Tannyr-Singleterry/ECE590_SeniorDesign/Documents/Draft A/ECE590__October_DesignSolution_Report.docx

Wildcat Rocketry Universal Flight Computer

LOGO GOES HERE

Submitted By:

The Apogeeniuses

Tannyr Singleterry

Gannon Bird

Ethan Benne

Nathan Emerson

10 October 2024

Executive Summary

Temp

Table of Contents

Executive Summary……………………………………………………………………………………………………………………..2

Table of Contents…………………………………………………………………………………………………………………………3

Project Description……………………………………………………………………………………………………………………...4

Background and Motivation ..X

Problem Statement ..X

Project Requirements ..X

Validation and Acceptance Tests ..X

Verification and Validation Matrix ..X

Data Needed to Support Analysis ..X

Technical Design ..X

Pre-Conceptual and Conceptual Design/Solution Descriptions ..X

Preliminary Design/Solution Description ..X

Detailed Design/Solution Descriptions ..X

Validation and Acceptance Test Results ..X

Assessment of Test Results ..X

Work Plan ..X

Work Breakdown Structure (WBS) & RACI Chart ..X

Schedule Gantt Chart ..X

Prototyping and Testing Protocol ..X

Financial Plan ..X

Proposed Budget ..X

Comparison of Final Expenditures to Budget ..X

Feasibility Assessment ..X

Lessons Learned ..X

Conclusions ..X

References ..X

Appendices ..X

Discussion

Project Description

This project is a Wildcat Rocketry flight computer. The goal of this project is to design and make a flight computer that will take in data from multiple sensors and produce accurate, reliable, and readable flight data.

Background and Motivation

Wildcat rocketry in the past has tried doing a various number of electronics projects. Some of these projects being a flight computer. However, most of these flight computers never got past the designing phase. If they did get past the design phase, they never got more than one board revision. This year Wildcat Rocketry is moving away from trying to design a flight computer and going towards Long Range tracking problem solving. The motivation for this senior design project is to design and construct a flight computer Wildcat Rocketry can be used as another way to get accurate flight data. As well Wildcat Rocketry can have a flight computer that they can build upon later for various other needs.

Project Requirements

Below is a table listing out different requirements for this project. The first ID dealing with power. ID 1.0 talking about the requirement that the flight computer needs to be powered from a 2S LiPo battery. The reason for this is because that is the all the commercial flight computers that Rocketry already uses are powered from these batteries. ID 1.a deals with the fact that Wildcat Rocketry would like the minimum battery life to be 2 hours. With the ideal battery life being 3-4 hours. ID 2 has to deal with the weight of the overall flight computer. Weight matters a significant amount when it comes to a rocket flying, so the less we can have the computer weigh the better. ID 3.0 deals with size. The flight computer must be constrained to a certain size. All the electronics for a rocket go inside of an avionics bay. Which has a certain inner diameter that the flight computer must fit inside of. This inner diameter typically being 3in-5in in width. ID 4.0 deals with cost. The cheaper Wildcat Rocketry and produce these flight computers the better. So we can have money that can go to other projects. ID 5.0 deals with all the Data the flight computer with obtain. Wildcat Rocketry wants the flight computers to store at least three flights worth of flight data. We got this number due to the commercial flight computers on the market hold this amount. ID 5.a talks about being able to take the data from the sensors on the flight computer and turning them into readable flight data. ID 5.b talks about being able to export the data over serial using USB-C and even visualize over WiFi.

ID | Requirement | Description
1.0 | Input Voltage and Current | 2S LiPo
1.a | Minimize Power Use | Design Goal: The longer we can power the board the better. Minimum of 2 hours of battery life. Would like 3-4 hours
2.0 | Weight | Maximum 100 grams
3.0 | Size | Maximum 3 in width, 4 in length
4.0 | Cost | $200 or less
5.0 | Data Logging | Store at least three flights worth of data
5.a | Data Processing | Be able to process data from sensors into readable flight data
5.b | Data Export | Be able to export that data over serial or visualize over WiFi

Validation and Acceptance Tests

We will be able to verify and validate our final design by demonstrating all the project requirements. We can demonstrate the power usage by putting the flight computer under load for a set amount of time and seeing how much voltage is left in the battery after. We can demonstrate the weight and size by measuring using the appropriate devices. The plan is to have two different board revisions, the first one being a testing unit with buttons and switches for debugging. While the second revision would be one that flies and gathers data actively during the flight. We can demonstrate the data processing, storage, and exporting using the first revision testing board.

Verification and Validation Matrix

ID | Requirement | Analysis | Demonstration | Inspection | Test
1.0 | Input Voltage and Current | | | | X
1.a | Minimize Power Usage | | | | X
2.0 | Weight | | | X
3.0 | Size | | | X
4.0 | Cost | X
5.0 | Data Logging | | | | X
5.a | Data Processing | | | | X
5.b | Data Export | | X

Data Needed to Support Analysis

The type of data needed for this project is different data produced from the sensors (High G accelerometer, IMU and barometer). We plan on collecting this data during flight, with the sensors talking to the Microcontroller and the Microcontroller will process this data.

Technical Design

Conceptual Design Descriptions

We had two alternative designs in mind for the flight computer. Our first alternative was to use a microcontroller to gather and process the sensor data, while our second was to use a Field Programmable Gate Array (FPGA). These options will now be explored:

Design Alternative 1: Microcontroller

Microcontrollers are powerful small computers used on a single integrated circuit. There is a wide variety of microcontrollers, differing with regards to processing power, I/O capabilities, and data storage. These are relatively easy to program because of the simplicity of serial execution and team experience in languages such as C/C++. Power consumption can be low, especially for a model optimized for a low power environment. Some disadvantages are the serial execution nature of microcontrollers which limits capabilities when multi-tasking, such as gathering data from multiple processors simultaneously and processing that data. The choice of microcontroller must consider the internal peripherals of the specific model such as General-Purpose Input/Output (GPIO) count.

Design Alternative 2: Field Programmable Gate Array (FPGA)

FPGAs are a configurable integrated circuit that can be repeatedly programmed after manufacturing. FPGAs contain logic blocks and allow a programmer to connect these blocks and configure them. The main advantage of using an FPGA is the logic level programming allows for design of a specialized multi-tasking circuit. This would mean that intake and processing of sensor data would be simultaneous and potentially increase the number of data points. It can also be reprogrammed to allow for quick iterating and bug fixing. There are two main disadvantages of an FPGA: The complexity of coding and the increase of power consumption. Programming at a logic level is less familiar to the team members as well as the Wildcat Rocketry members which decreases the ability for future iteration. The other disadvantage is that to utilize the increased speed of parallel processing, more power is consumed.

Selection Process for Preliminary Design Solution

We used an evaluation matrix to decide between implementing the flight computer with a microcontroller or an FPGA. Compactness and reliability were our two most weighted requirements because those are especially applicable for the size of the rocket and for consistent data. Concept 1 represents the microcontroller while concept 2 represents the FPGA.

Need | Engineering Requirement | Weight (1-10) | Base line | Concept 1 | Concept 2
Lightweight | Weight < 100 grams | 3 | 5 | 5 | 5
Lower Power Consumption | Minimum 2 hours battery life | 5 | 5 | 7 | 3
Data storage | Can store multiple flights worth of data | 7 | 5 | 7 | 5
Ease of use | Easy to use interface | 7 | 5 | 9 | 3
Affordability | Unit production cost < $200 | 3 | 5 | 7 | 3
Connectivity | Be able to output data via serial | 5 | 5 | 5 | 5
Reliability | Produces data consistently | 10 | 5 | 4 | 6
Compact | 3 inches width, 4 inches length | 10 | 5 | 7 | 5
Accuracy | Produces accurate data | 7 | 5 | 4 | 7
Total | | | 285 | 346 | 279

Table 3 Decision Matrix

Our final choice was the microcontroller. Some major factors over the FPGA were ease of use and power consumption.

Preliminary Design/Solution Description

Global Issues

This is to be used for K-State Rocketry Club so global issues do not pertain.

System-Level Overview

The flight computer will gather data from the flight and store that data for later analysis. It is meant to be easily expandable.


Figure 1 System Block Diagram

Applicable Standards

TEMP

Module-Level Descriptions

Sensors:

The sensors consist of a high-G accelerometer, barometer, and an Inertial Measurement Unit which itself consists of a low-G accelerometer, gyroscope, and magnetometer. These sensors are typical and required in a flight computer and will be used to gather data on pressure, acceleration, heading, and tilt.

Flight Computer PCB:

The Flight Computer PCB module will consist of a microprocessor on a custom-made PCB.

External Memory:

Multiple flights worth of data necessitates the use of external memory in the form of an SD card.

Output Data:

Data from each flight can be output via USB-C on the PCB, or by Wi-Fi access by the wireless chip on the board.

Detailed Design/Solution Descriptions

THIS IS SEMESTER TWO ONLY

Validation and Acceptance Test Results

THIS IS SEMESTER TWO ONLY

Assessment of Test Results

THIS IS SEMESTER TWO ONLY

Work Plan

This section our group is still finalizing details and tasks.

Work Breakdown Structure & RACI Chart

Here is a rough RACI chart. To be fixed and change later.

Task # | Task | Tannyr | Gannon | Nathan | Ethan
1 | Designing PCB | --- | --- | --- | ---
1a | Footprints | | R | | A
1b | Schematics | | A | | R
1c | PCB Design | | R | | A
2 | Design Software | --- | --- | --- | ---
2a | Flight Software | R | | A
2b | Data Visualization | A | | R
3 | Communicating with Client | R
4 | Possible Board Assembly | A | A | A | R
5 | Testing | A | | R

R = Responsible, A = Assisting

Schedule Gantt Chart

Plan to add soon.

Prototyping and Testing Protocol

The first revision board for this project will be the testing board. We will create artificial flight data to be sent to the flight computer for it to process. We will use either the Senior Design lab or Electronics Design Club room for lab space. Safety aspects to be considered is a potential fire hazard with using a battery. We will make sure to always have a fire extinguisher close by.

ADD TEST FLOW DIAGRAM HERE LATER.

Financial Plan

This section covers the costs of the project

Proposed Budget

Here is a preliminary bill of materials for the first board revision.

- First board Revision
  - PCB - $4.00
  - Sensors - $20.00
  - Microcontroller - $10.00
  - IMU - $30.00

For a total of $64. This is bound to change based on components and PCB costs.

TALK ABOUT STEPS 2-5 IN OUTLINE.

Comparison of Final Expenditures to Budget

THIS IS SEMESTER TWO ONLY

Feasibility Assessment

We believe that this project is feasible. Our group has a mix of Electrical and Computer Engineers. Most of us have other project experience through classes or clubs. The biggest weakness with our team will be communication. We must make sure to always be communicating what needs to be done and what we plan on doing as group members. All of us are a part of clubs and have jobs along with school. The best course to solve these is to utilize our given work time wisely.

FILL MORE LATER WITH RATED AND RANKED PROJECT RISKS

Lessons Learned

TO BE DONE LATER.

Conclusions

TO BE DONE LATER.

REFRENCES

[1] Temp

APPENDEICIES

Temp
