Tannyr-Singleterry/ECE590_SeniorDesign/To-Do.docx

- Group
  - Adjust gantt chart
  - Start reviewing final presentation and draft
  - Adjust RACI chart more?
- Firmware
  - Look at what coding languages we want. Do some tests in the testing folder
    - C++
      - Matplot++ library
    - C
      - Less power intensive (maybe minimal?)
- Hardware
  - GANNON FOR THE LOVE OF GOD FINSIH THE ESP AND POWER SCHEMATICS
  - Do routing
    - Plan for Gannon to place all components and have everyone route
- MISC
  - Temp
