Tannyr-Singleterry/ECE590_SeniorDesign/Documents/RFA/ECE590_BlockDiagram.pdf

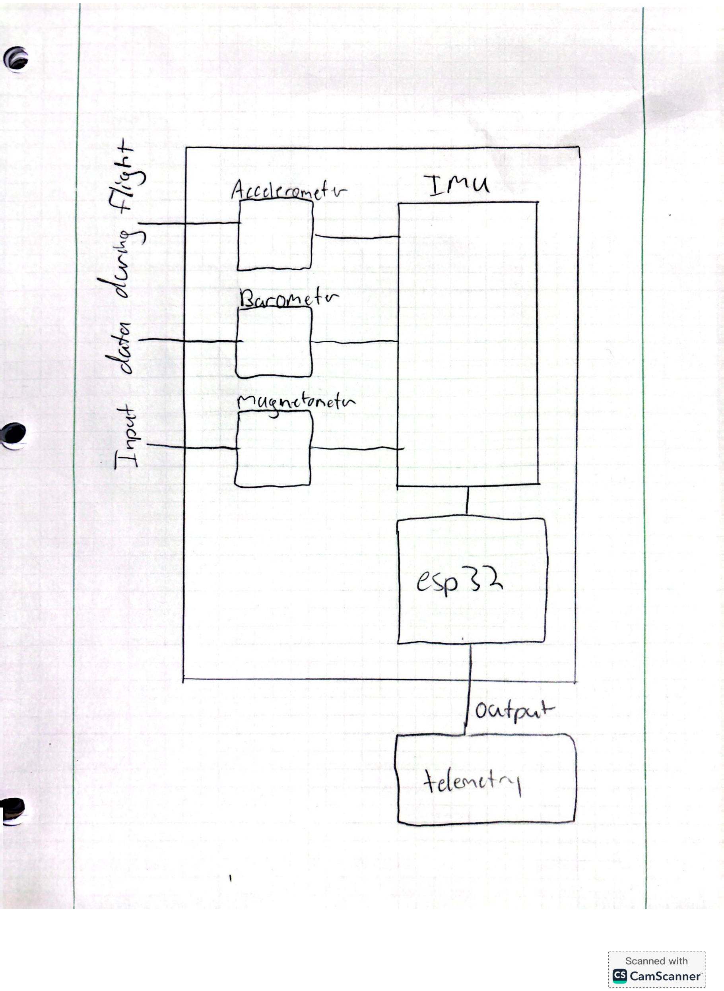
[picture p42: page 1]
