Tannyr-Singleterry/ECE590_SeniorDesign/Inventory of Parts.xlsx

Part | Quantity (That aren't used) | Notes if applicable
ESP32-S3-WROOM | 2 | Came with 3, used one for one board
USB4 105-GF-A | 3 | Came with 4, used one for one board.
IMU ACCEL/GRYO/MAG I2C 32BIT | 1 | Came with 2, used one for one board.
Physical Boards | 5 | One fully assembled, one partly assembled, other 3 blank distrubted among team members
