Tannyr-Singleterry/ECE590_SeniorDesign/Electronics/Component_Selection.xlsx

Part Number | Short Description | Quantity Per Board | Digikey Cost Per | Digikey Cost | JLC Assembly? | JLC Extended Part? | JLC Part Number | JLC Cost per | Assembly Cost
ESP32-S3-WROOM-1 | ESP32 MCU Module | 1 | $3.48 | $3.48 | NO | FALSE | N/A | $0.00 | $0.00
ICM-20948 | 9-axis IMU/LOW G Acc | 1 | $9.34 | $9.34 | YES | TRUE | C726001 | $4.86 | $7.86
MS560702BA03-50 | Barometor | 1 | $10.86 | $10.86 | YES | TRUE | C97627 | $3.01 | $6.01
ADXL375BCCZ-RL7 | High G Acc | 1 | $16.40 | $16.40 | YES | TRUE | C481898 | $5.42 | $8.42
W25Q128JVSIM | 128kB Flash | 1 | $1.75 | $1.75 | YES | TRUE | C2613930 | $0.92 | $3.92
PKM13EPYH4000-A0 | Buzzer | 1 | $0.41 | $0.41 | NO | FALSE | N/A |  | $0.00
 |  |  |  | $0.00 |  |  |  |  | $0.00
 |  |  |  | $0.00 |  |  |  |  | $0.00
 |  |  |  |  |  |  |  |  | $0.00
 |  |  |  |  |  |  |  |  | $0.00
 |  |  |  |  |  |  |  |  | $0.00
