Tannyr-Singleterry/ECE590_SeniorDesign/Electronics/KiCAD/APG_Sensor_Test_Board/APG_Sensor_Test_Board.xlsx

Comment | Designator | Footprint | JLCPCB
TLV75533PDBV | U7 | Package_TO_SOT_SMD:SOT-23-5 | C404027
USBULC6-2M6 | U6 | Package_DFN_QFN:ST_UQFN-6L_1.5x1.7mm_P0.5mm | C672213
W25Q128JVS | U5 | Package_SO:SOIC-8_5.23x5.23mm_P1.27mm | C97521
MS5607-02BA | U4 | Package_LGA:LGA-8_3x5mm_P1.25mm | C97627
ADXL375 | U3 | Package_LGA:LGA-14_3x5mm_P0.8mm_LayoutBorder1x6y | C481898
ESP32-S3-WROOM-1 | U1 | RF_Module:ESP32-S3-WROOM-1
100k | R9,R10,R25,R26 | Resistor_SMD:R_0603_1608Metric
0 | R5,R6,R11,R13,R16,R17,R19,R20 | Resistor_SMD:R_0603_1608Metric
5.1k | R27,R28 | Resistor_SMD:R_0603_1608Metric
51 | R22,R24 | Resistor_SMD:R_0603_1608Metric
10k | R1,R2,R3,R4,R12,R14,R15,R21,R29,R30,R31,R32 | Resistor_SMD:R_0603_1608Metric
20 | R23 | Resistor_SMD:R_0603_1608Metric
RE1C002UNTCL | Q1 | Package_TO_SOT_SMD:SOT-416 | C509959
SS12 | D4 | Diode_SMD:D_SMA | C184027
Red | D3 | LED_SMD:LED_0805_2012Metric | C84256
Green | D2 | LED_SMD:LED_0805_2012Metric | C2297
Yellow | D1 | LED_SMD:LED_0805_2012Metric | C2296
1uF | C8,C15 | Capacitor_SMD:C_0603_1608Metric
1u | C11,C16,C17 | Capacitor_SMD:C_0603_1608Metric
0.1uF | C1,C2,C4,C6,C7,C9,C10,C12,C13,C14 | Capacitor_SMD:C_0603_1608Metric
1uf | C5 | Capacitor_SMD:C_0603_1608Metric
22uF | C3 | Capacitor_SMD:C_0603_1608Metric
