Tannyr-Singleterry/ECE590_SeniorDesign/Documents/APG_SrDesCombinedSheet1.xlsx

Sheet: Requirements
ID | Requirement | Description
1.0 | Input Voltage and Current | 2S LiPo
1.a | Minimize Power Use | Desgin Goal: The longer we can power the board the better. Minimum of 2 hours of battery life. Would like 3-4 hours
2.0 | Weight | Maximum 100 grams
3.0 | Size | Maximum 3 in width, 4 in length
4.0 | Cost | $200 or less
5.0 | Data Logging | Store at least three flights worth of data
5.a | Data Processing | Be able to process data from sensors into readable flight data
5.b | Data Export | Be able to export that data over serial or visualize over WiFi
6.0
7.0
8.0
9.0
10.0
11.0
12.0
13.0
14.0
15.0
16.0
17.0
18.0
19.0

Sheet: Verification
ID | Requirement | Analysis | Demonstration | Inspection | Test
1.0 | Input Voltage and Current |  |  |  | X
1.a | Minimize Power Usage ( W) |  |  |  | X
1.b | Input Voltage of ()V |  |  |  | X
1.c | Input Current of ()mA |  |  |  | X
2.0 | Weight |  |  | X
3.0 | Size |  |  | X
4.0 | Cost | X
5.0 | Data Logging |  |  |  | X
5.a | Data Processing |  |  |  | X
6.0 | Data Export |  | X
6.a | WiFi Data Visualization |  | X
6.b | USB Data Export |  | X

Sheet: Decision Matrix
Need | Engineering Requirement | Weight (1-10) | Base line | Concept 1 | Concept 2
Lightweight | Weight < 100 grams | 3 | 5 | 5 | 5
Lower Power Consumption | Minimum 2 hours battery life | 5 | 5 | 7 | 3
Data storage | Can store multiple flights worth of data | 7 | 5 | 7 | 5
Ease of use | Easy to use interface | 7 | 5 | 9 | 3
Affordability | Unit production cost < $200 | 3 | 5 | 7 | 3
Connectivity | Be able to output data via serial | 5 | 5 | 5 | 5
Reliability | Produces data consistantly | 10 | 5 | 4 | 6
Compact | 3 inches width, 4 inches length | 10 | 5 | 7 | 5
Accuracy | Produces accurate data | 7 | 5 | 4 | 7
Total |  |  | 285 | 346 | 279
