Tannyr-Singleterry/ECE590_SeniorDesign/Documents/RFA/Flight Computer Budget.xlsx

Component | Link | Price
PCB |  | $4.00
Temp Sensor |  | $5.00
Microcontroller |  | $10.00
IMU |  | $30.00
Total |  | $49.00
