Tannyr-Singleterry/ECE590_SeniorDesign/Documents/Basic deploy Schematics/Basic Deploy Doc.PDF

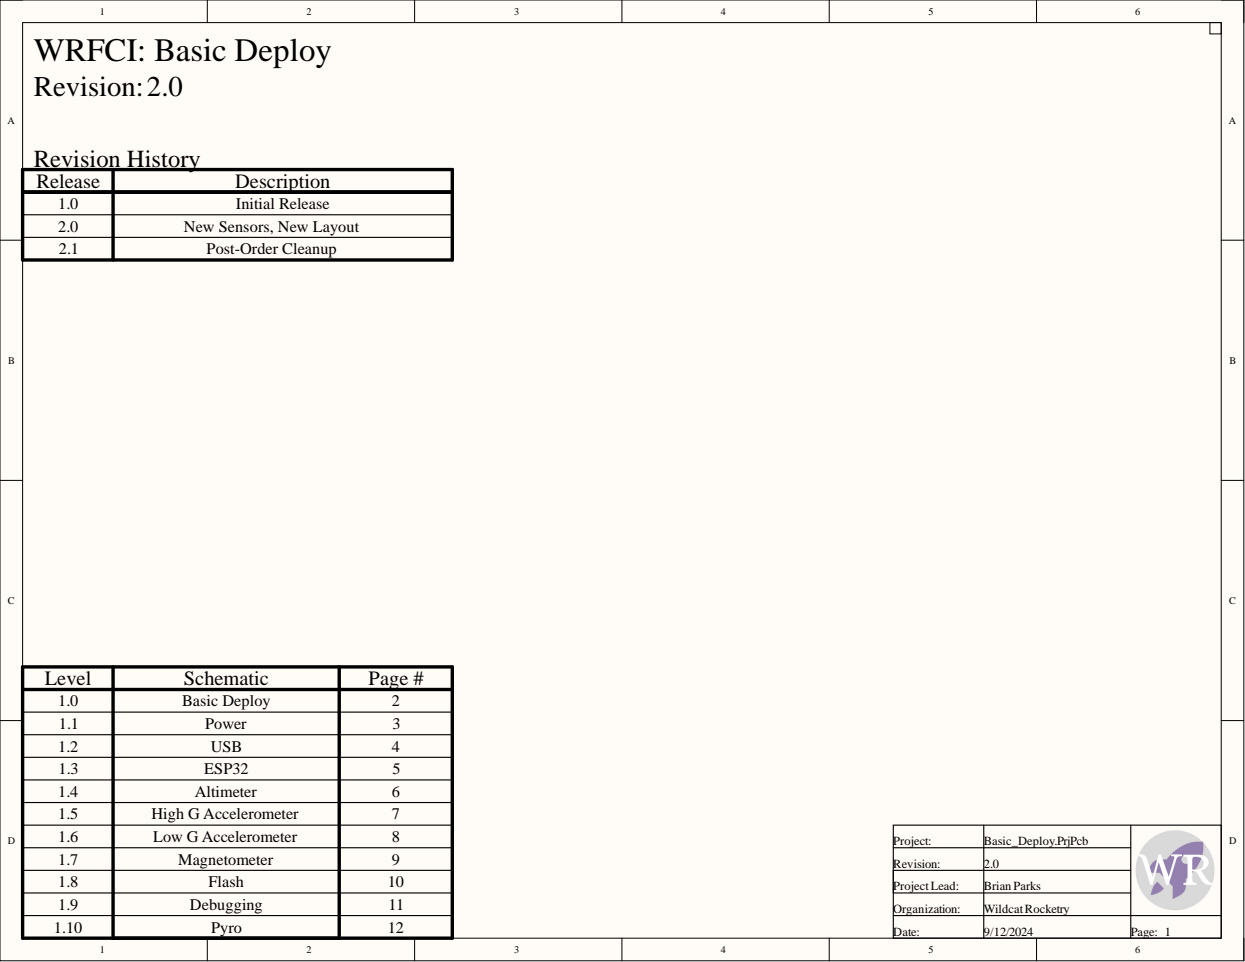
[picture p43: page 1]

Release | Description
1.0 | Initial Release
2.0 | New Sensors, New Layout
2.1 | Post-Order Cleanup

Level | Schematic | Page #
1.0 | Basic Deploy | 2
1.1 | Power | 3
1.2 | USB | 4
1.3 | ESP32 | 5
1.4 | Altimeter | 6
1.5 | High G Accelerometer | 7

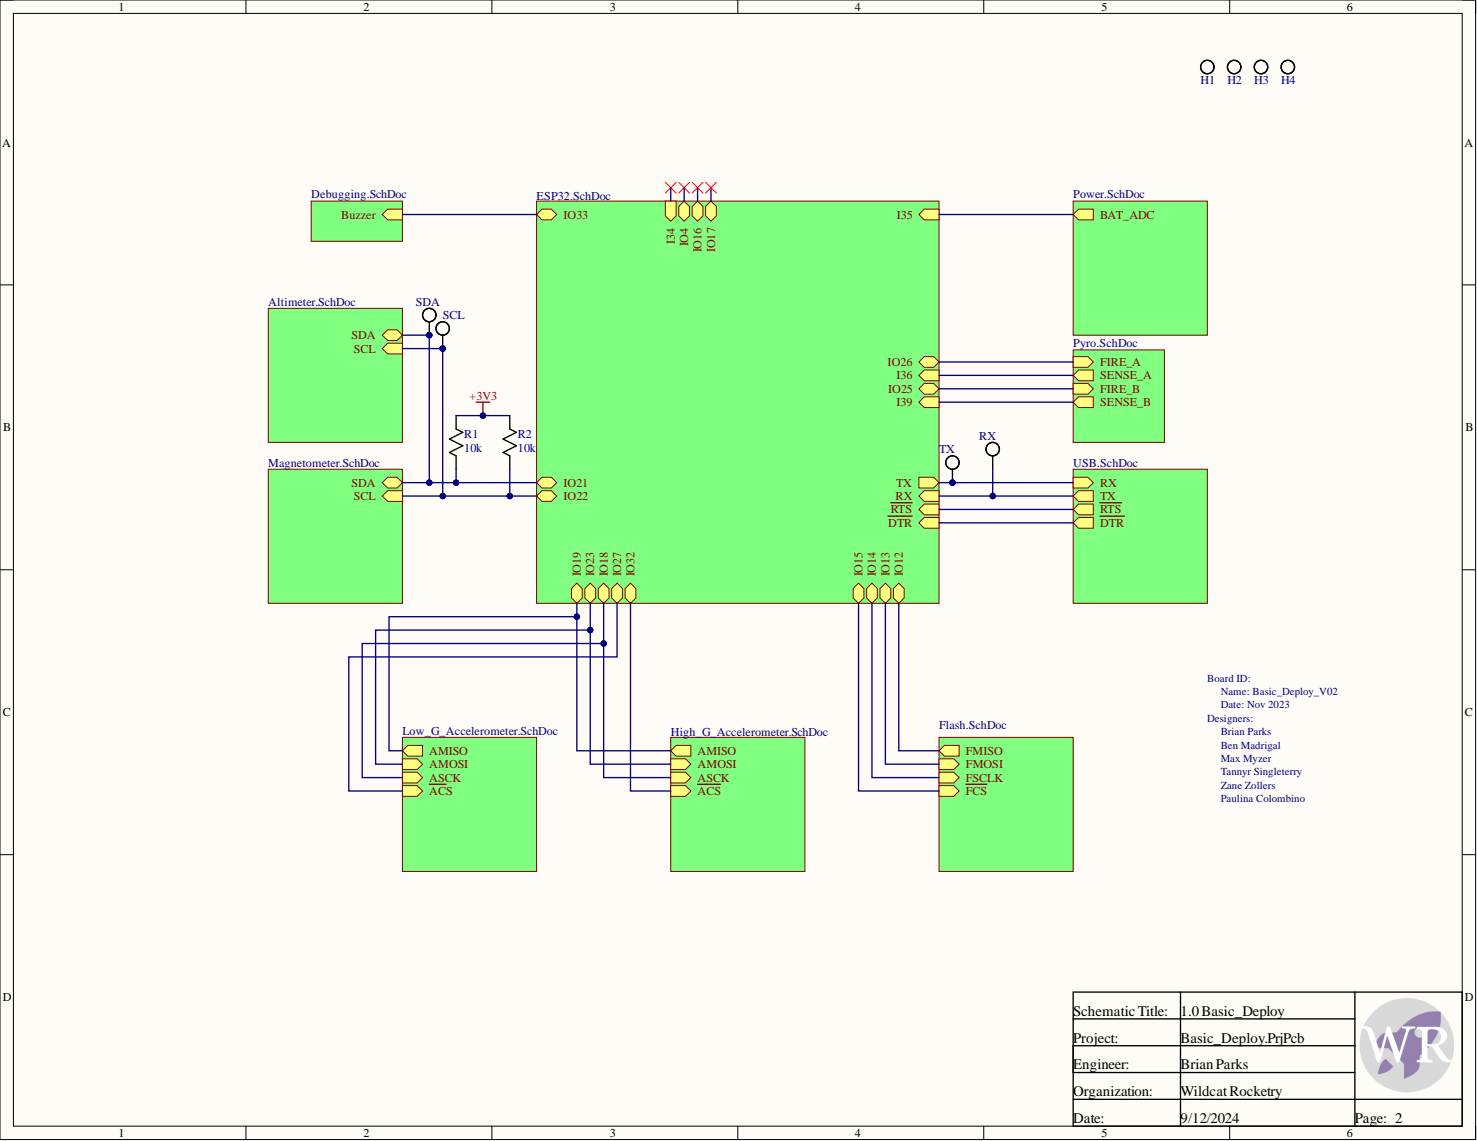
[picture p44: page 2]

SchematicTitle: | 1.0Basic_Deploy

Project: | Basic_Deploy.PrjPcb

Engineer: | Brian Parks

Organization: | Wildcat Rocketry

Date: | 9/12/2024 | Page: 2

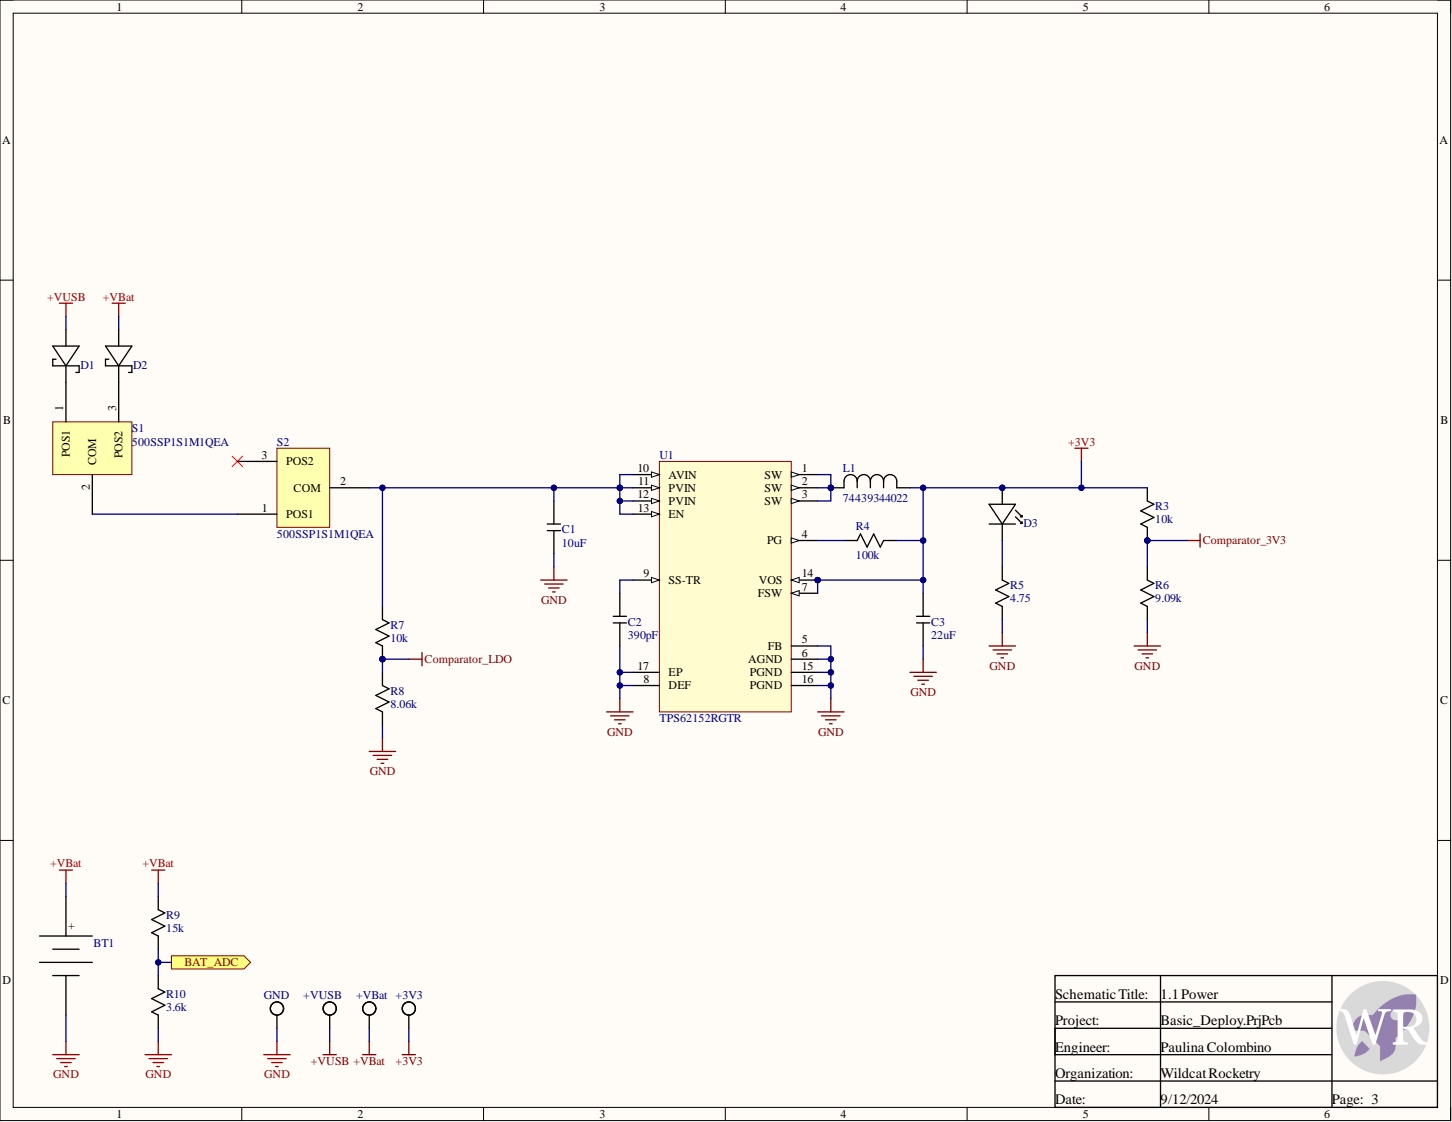
[picture p45: page 3]

S c h ematic Titl e : | 1.1 P owe r

Proje c t : | Basic _De plo y . Prj Pc b

En gin e e r : | P a ulin aColo mb i n o

Or g a niz ati o n : | Wild c at Ro c k e try

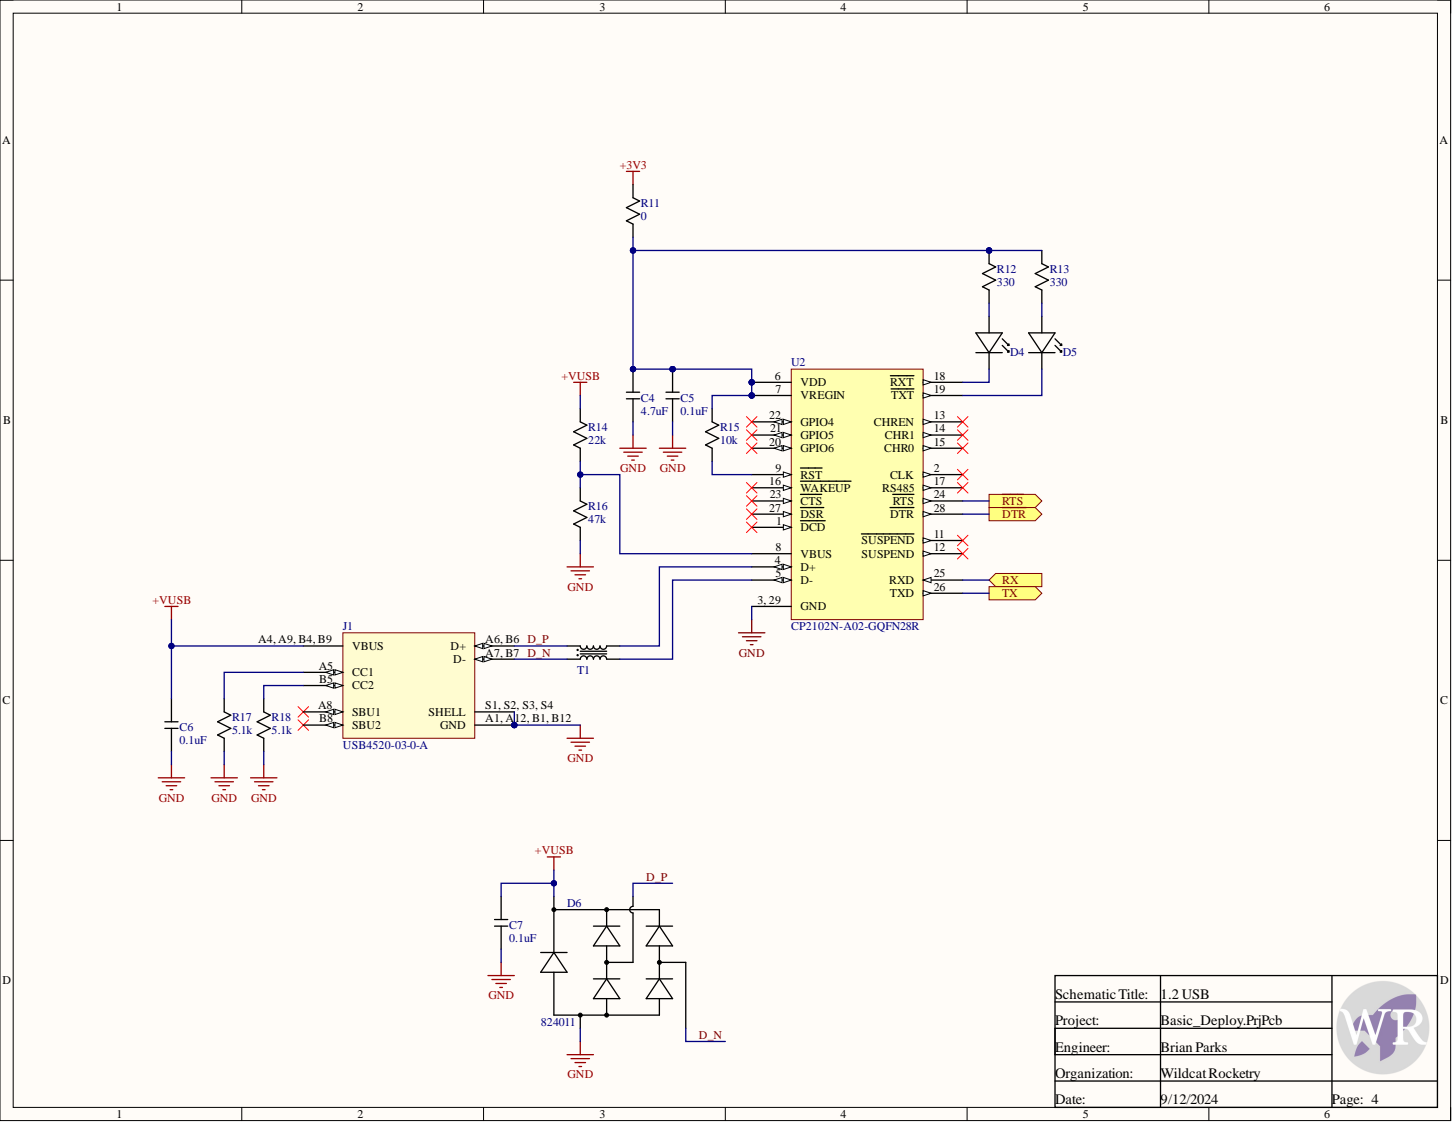
[picture p46: page 4]

S c h ematic Titl e : | 1.2 US B

Proje c t : | Basic _De plo y . Prj Pc b

Or g a niz ati o n : | Wild c at Ro c k e try

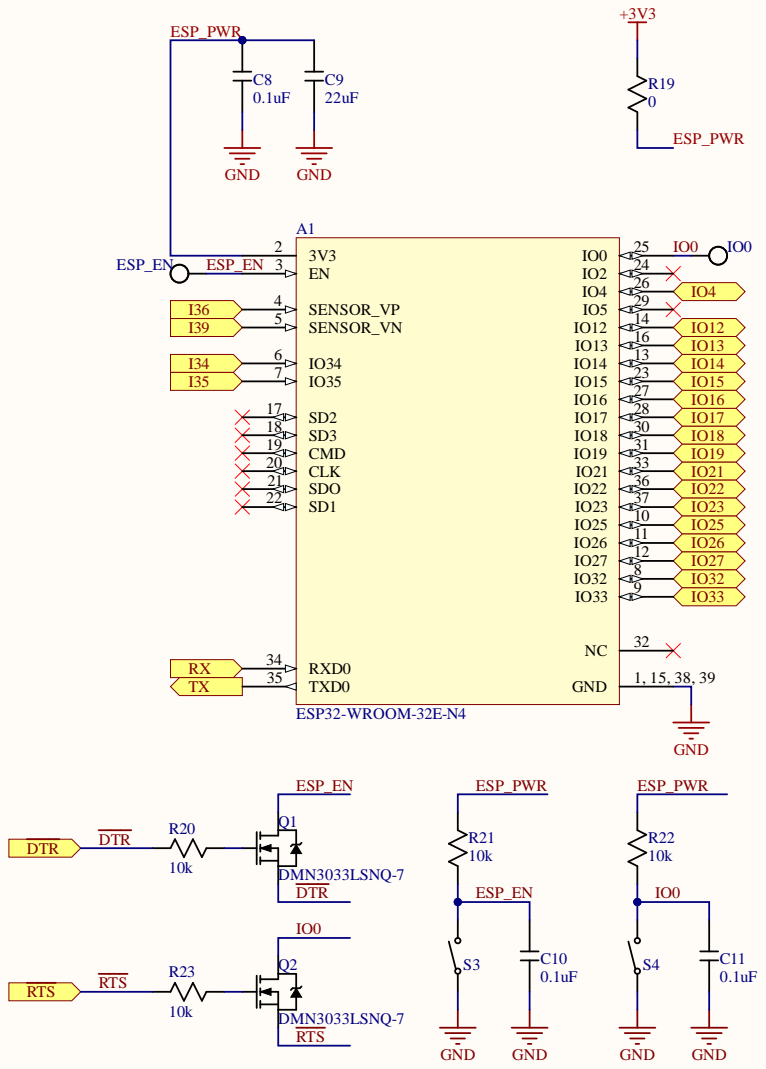
[picture p47: page 5]

SchematicTitle: | 1.3 ESP32

Project: | Basic_Deploy.PrjPcb

Engineer: | Brian Parks

Organization: | Wildcat Rocketry

Date: | 9/12/2024 | Page: 5

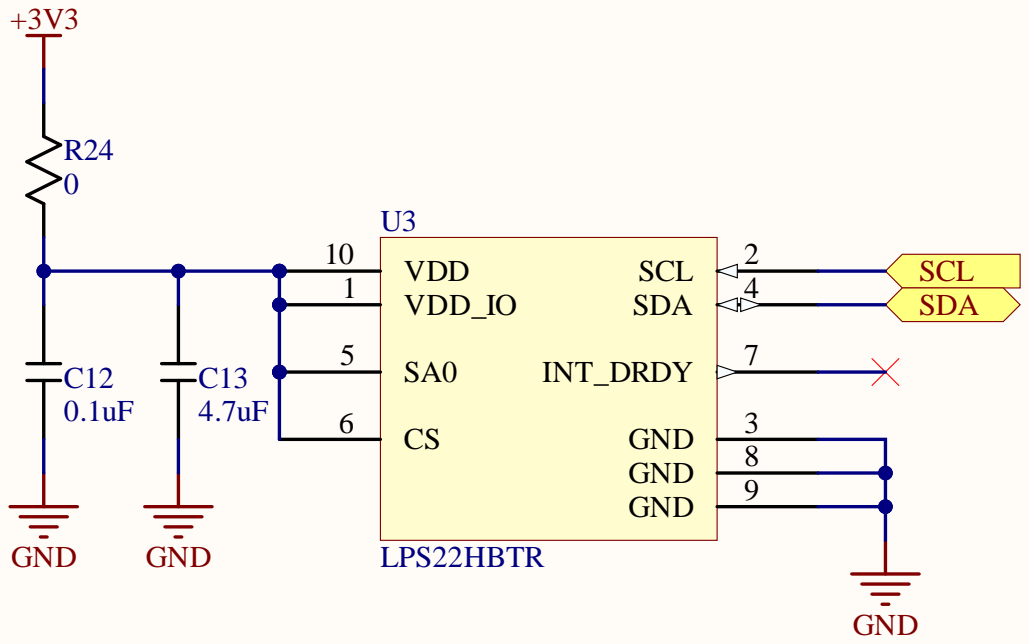
[picture p48: page 6]

S c h ematic Titl e : | 1.4 Altime te r

Proje c t : | Basic _De plo y . Prj Pc b

En gin e e r : | M a x M y z e r

Or g a niz ati o n : | Wild c at Ro c k e try

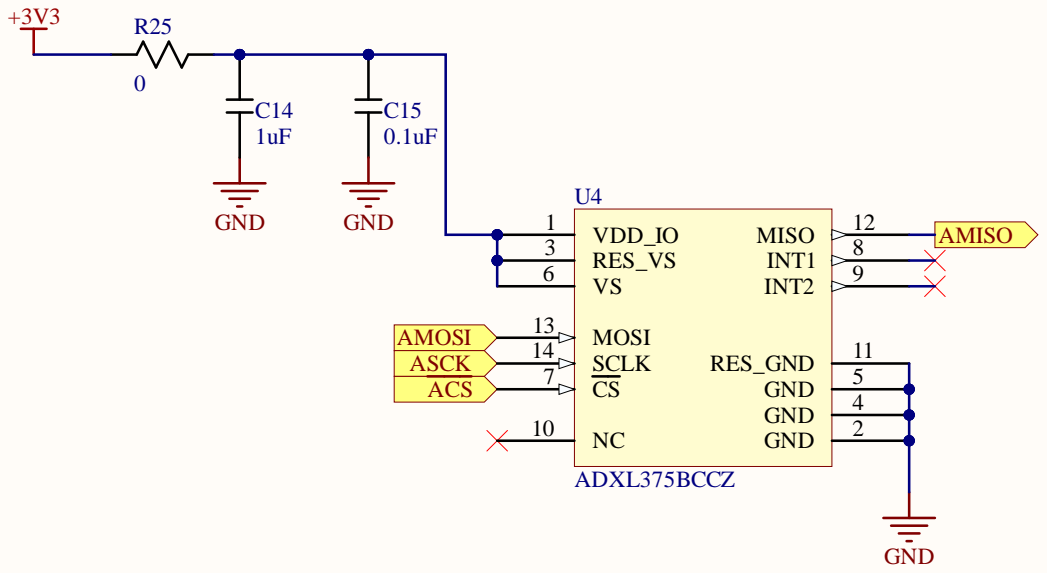
[picture p49: page 7]

SchematicTitle: | 1.5 High_G_Accelerometer

Project: | Basic_Deploy.PrjPcb

Engineer: | Zane Zollers

Organization: | Wildcat Rocketry

Date: | 9/12/2024 | Page: 7

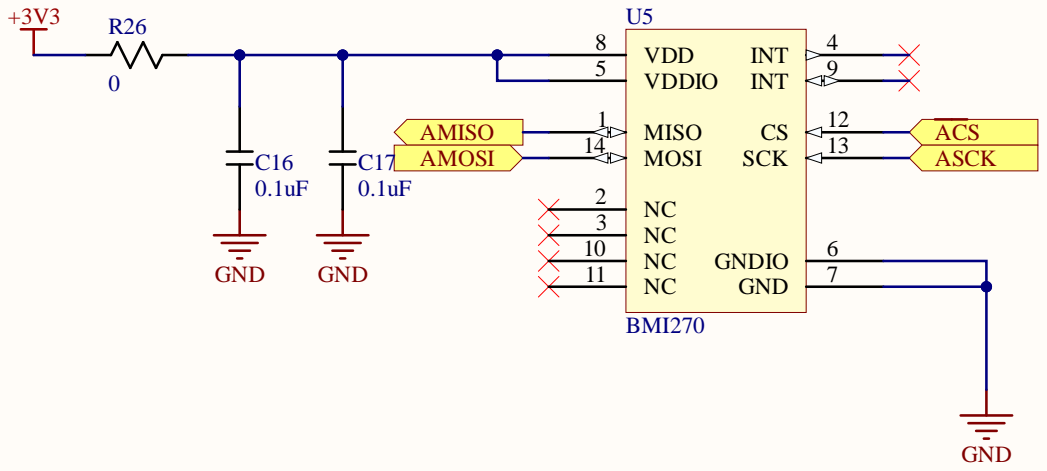
[picture p50: page 8]

SchematicTitle: | 1.6 Low_G_Accelerometer

Project: | Basic_Deploy.PrjPcb

Engineer: | Zane Zollers

Organization: | Wildcat Rocketry

Date: | 9/12/2024 | Page: 8

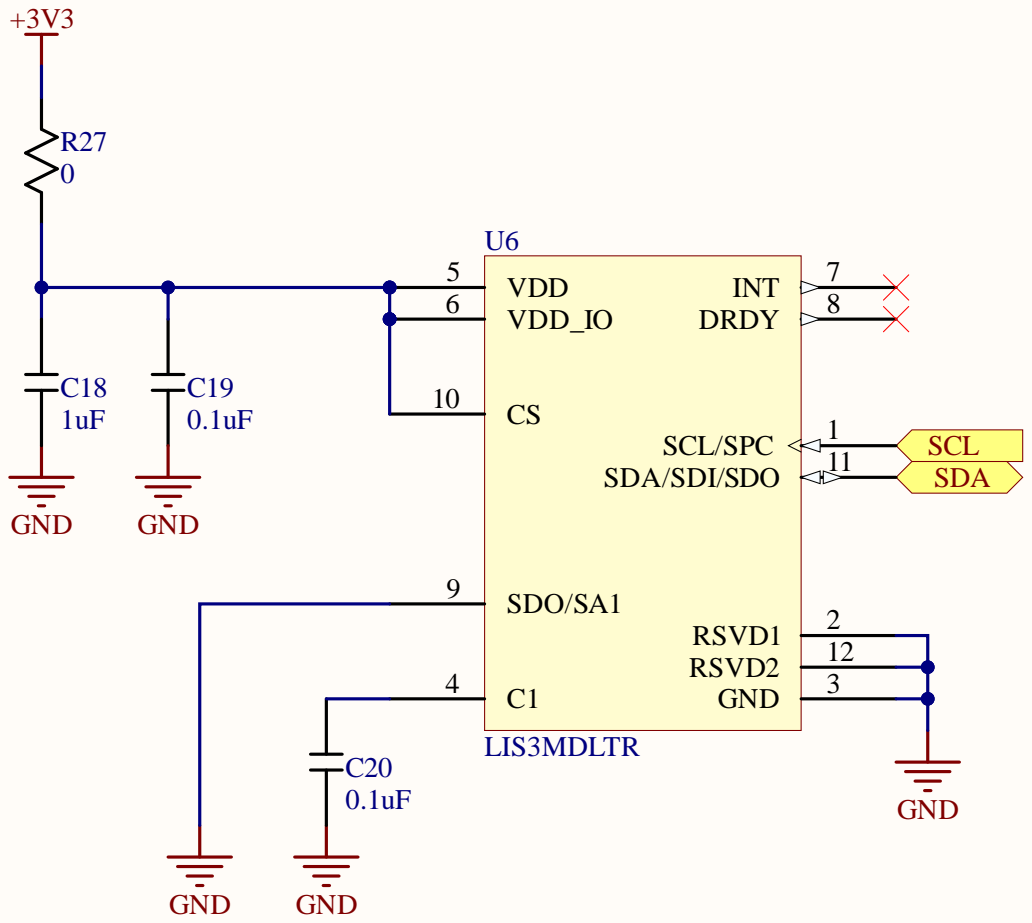
[picture p51: page 9]

1 2

S c h ematic Titl e : | 1.7 M a g n eto m e te r

Proje c t : | Basic _De plo y . Prj Pc b

En gin e e r : | Ta n n yr Sin gle te rry

Or g a niz ati o n : | Wild c at Ro c k e try

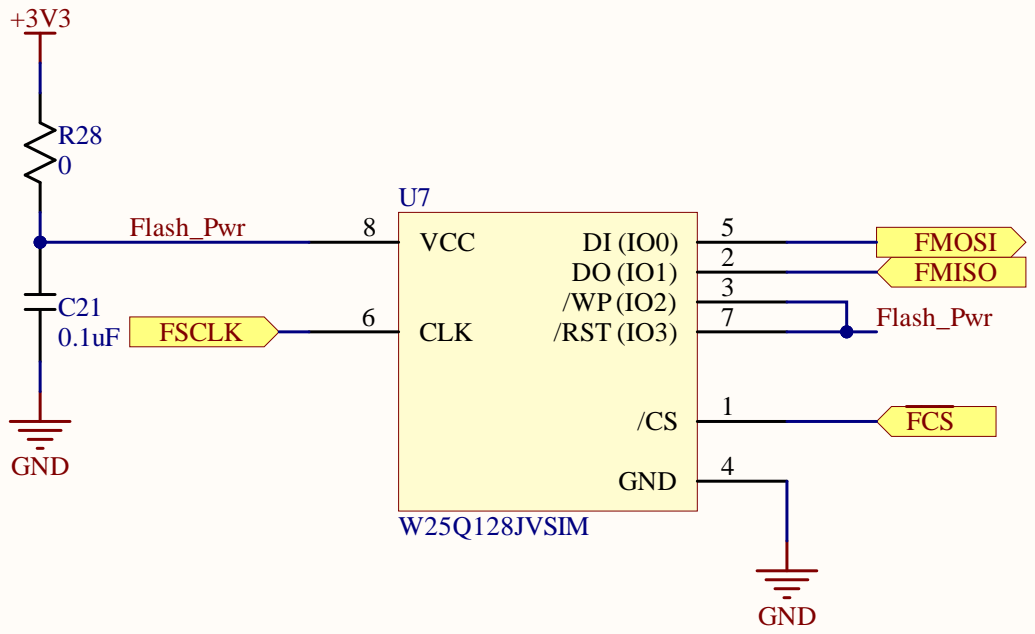
[picture p52: page 10]

SchematicTitle: | 1.8 Flash

Project: | Basic_Deploy.PrjPcb

Engineer: | Max Myzer

Organization: | Wildcat Rocketry

Date: | 9/12/2024 | Page: 10

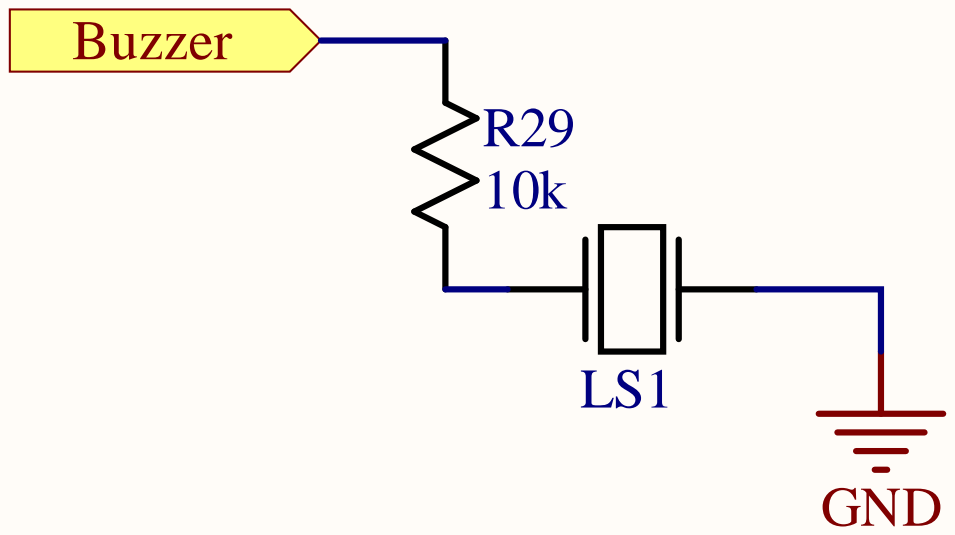
[picture p53: page 11]

SchematicTitle: | 1.9 Debugging

Project: | Basic_Deploy.PrjPcb

Engineer: | Tannyr Singleterry

Organization: | Wildcat Rocketry

Date: | 9/12/2024 | Page: 11

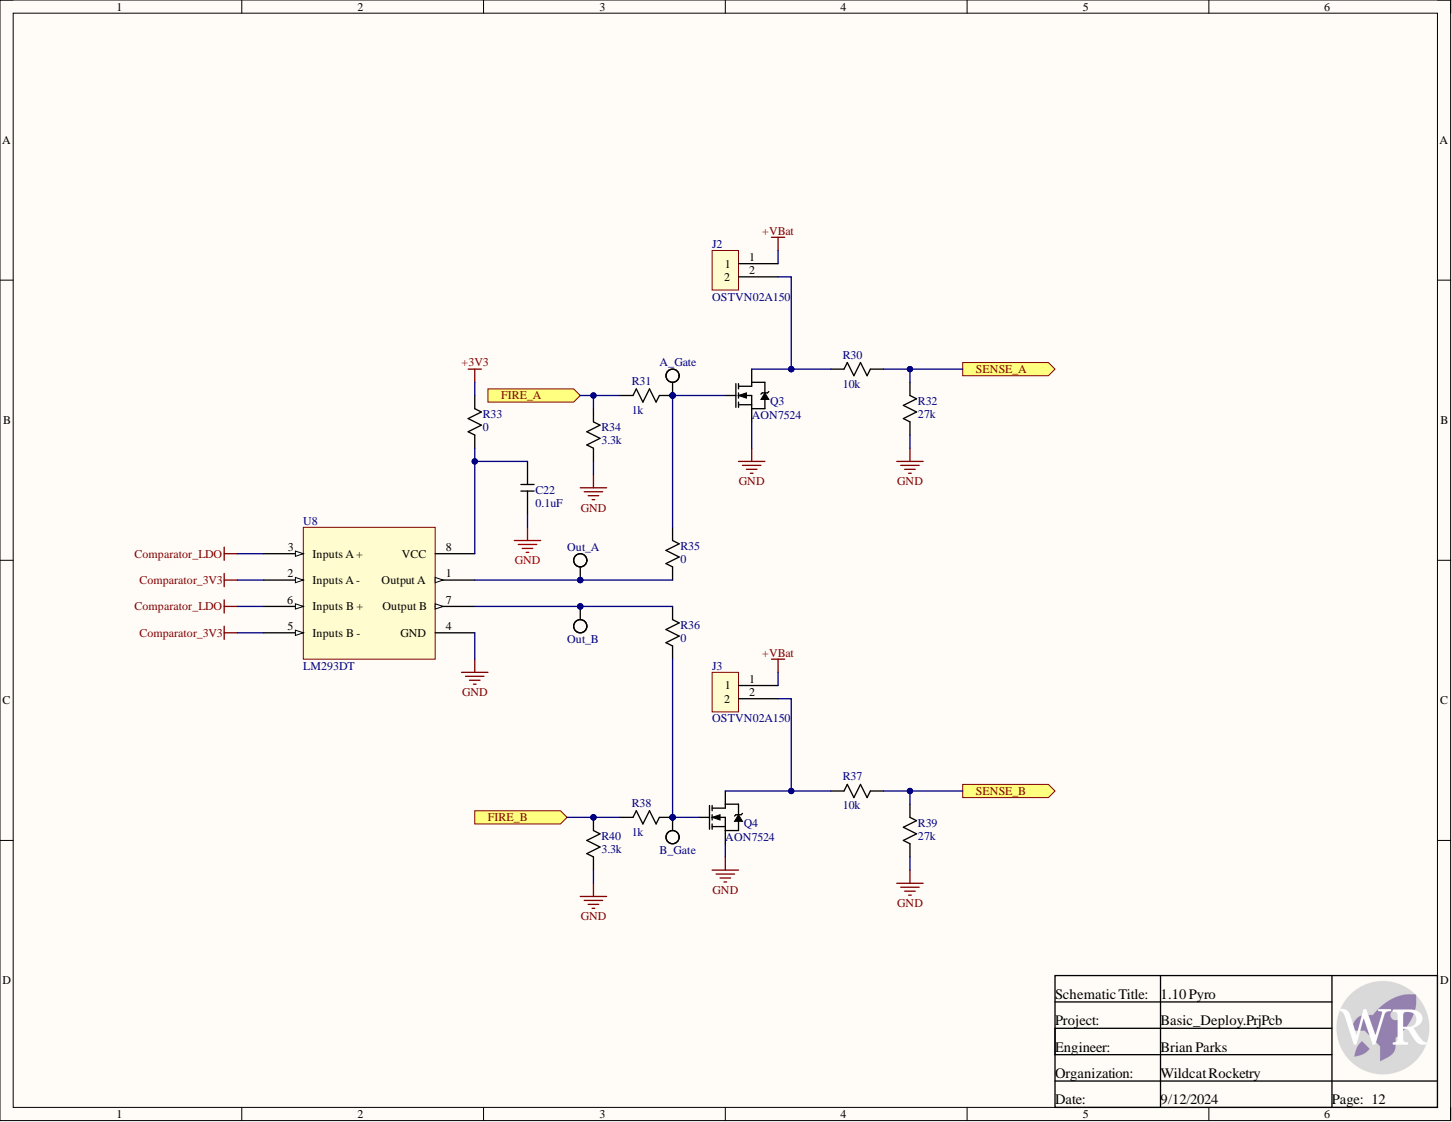
[picture p54: page 12]

SchematicTitle: | 1.10 Pyro

Project: | Basic_Deploy.PrjPcb

Engineer: | Brian Parks

Organization: | Wildcat Rocketry

Date: | 9/12/2024 | Page: 12

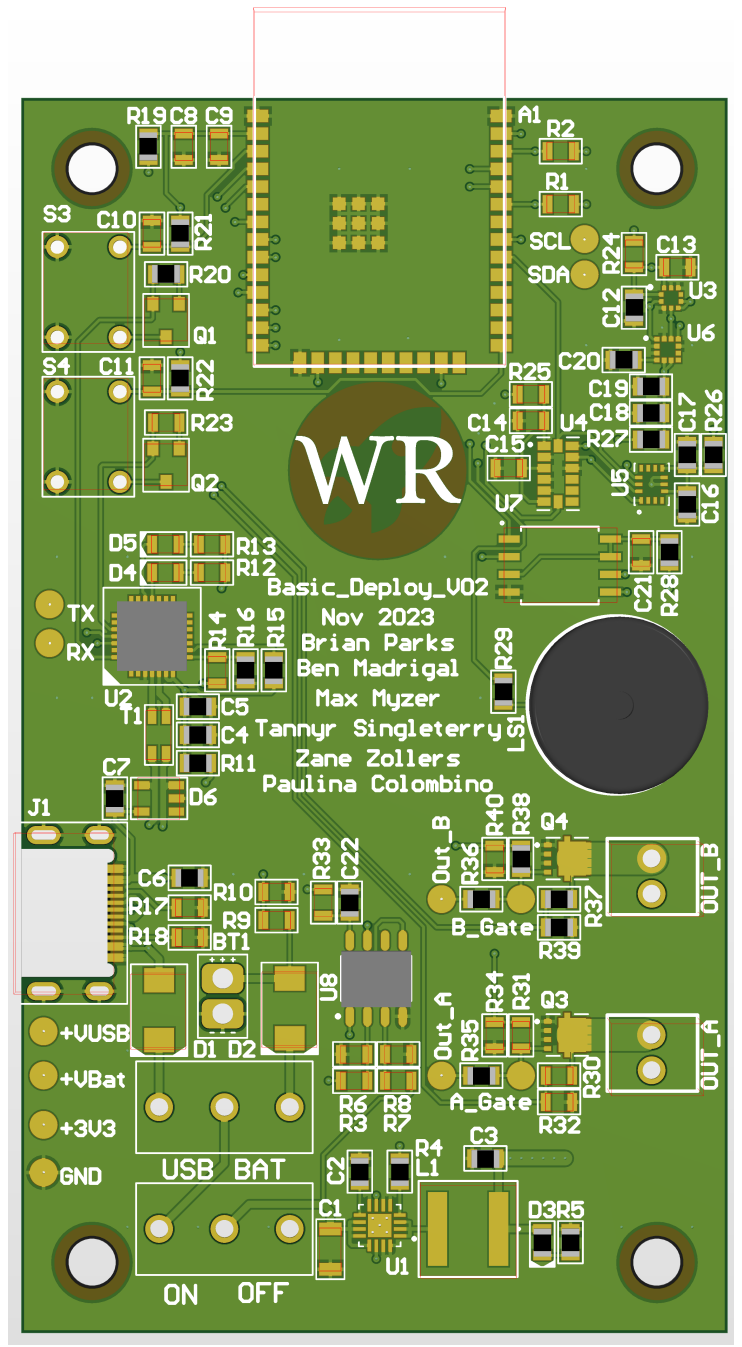
[picture p55: page 13]

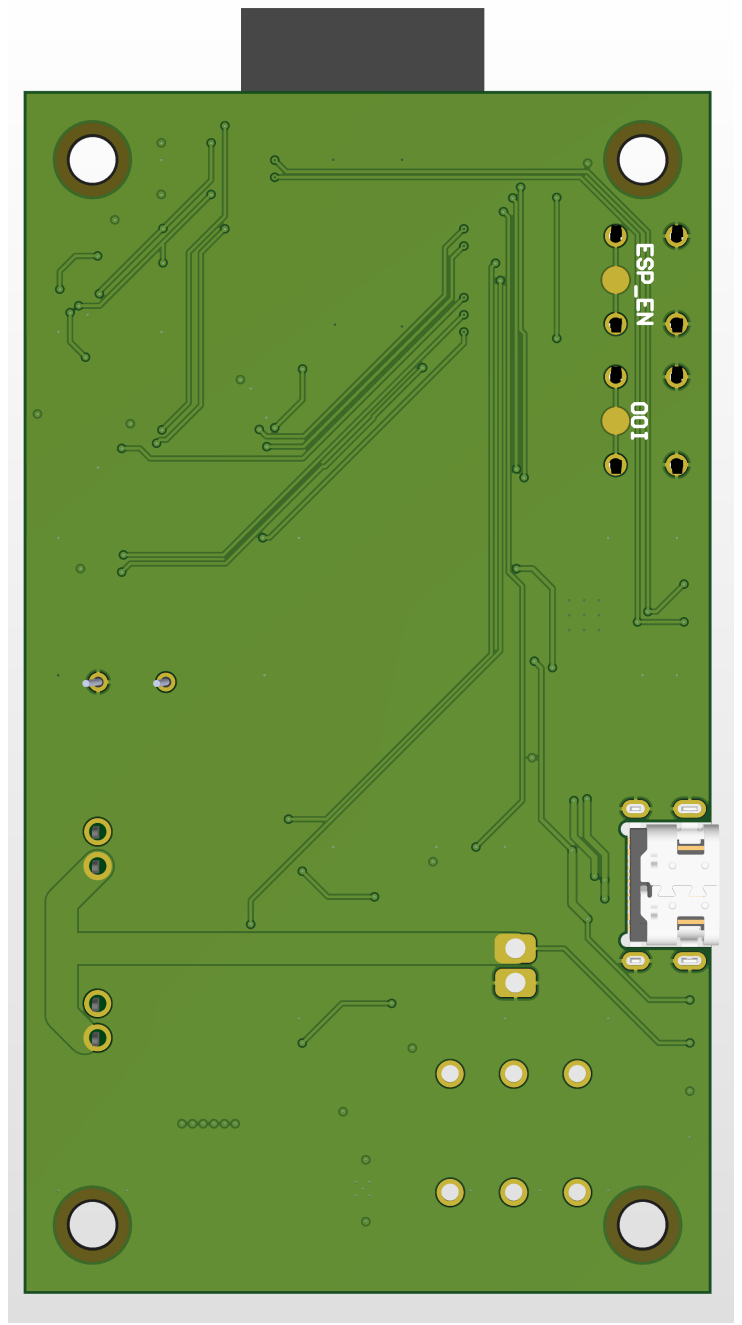
[picture p56: page 14]

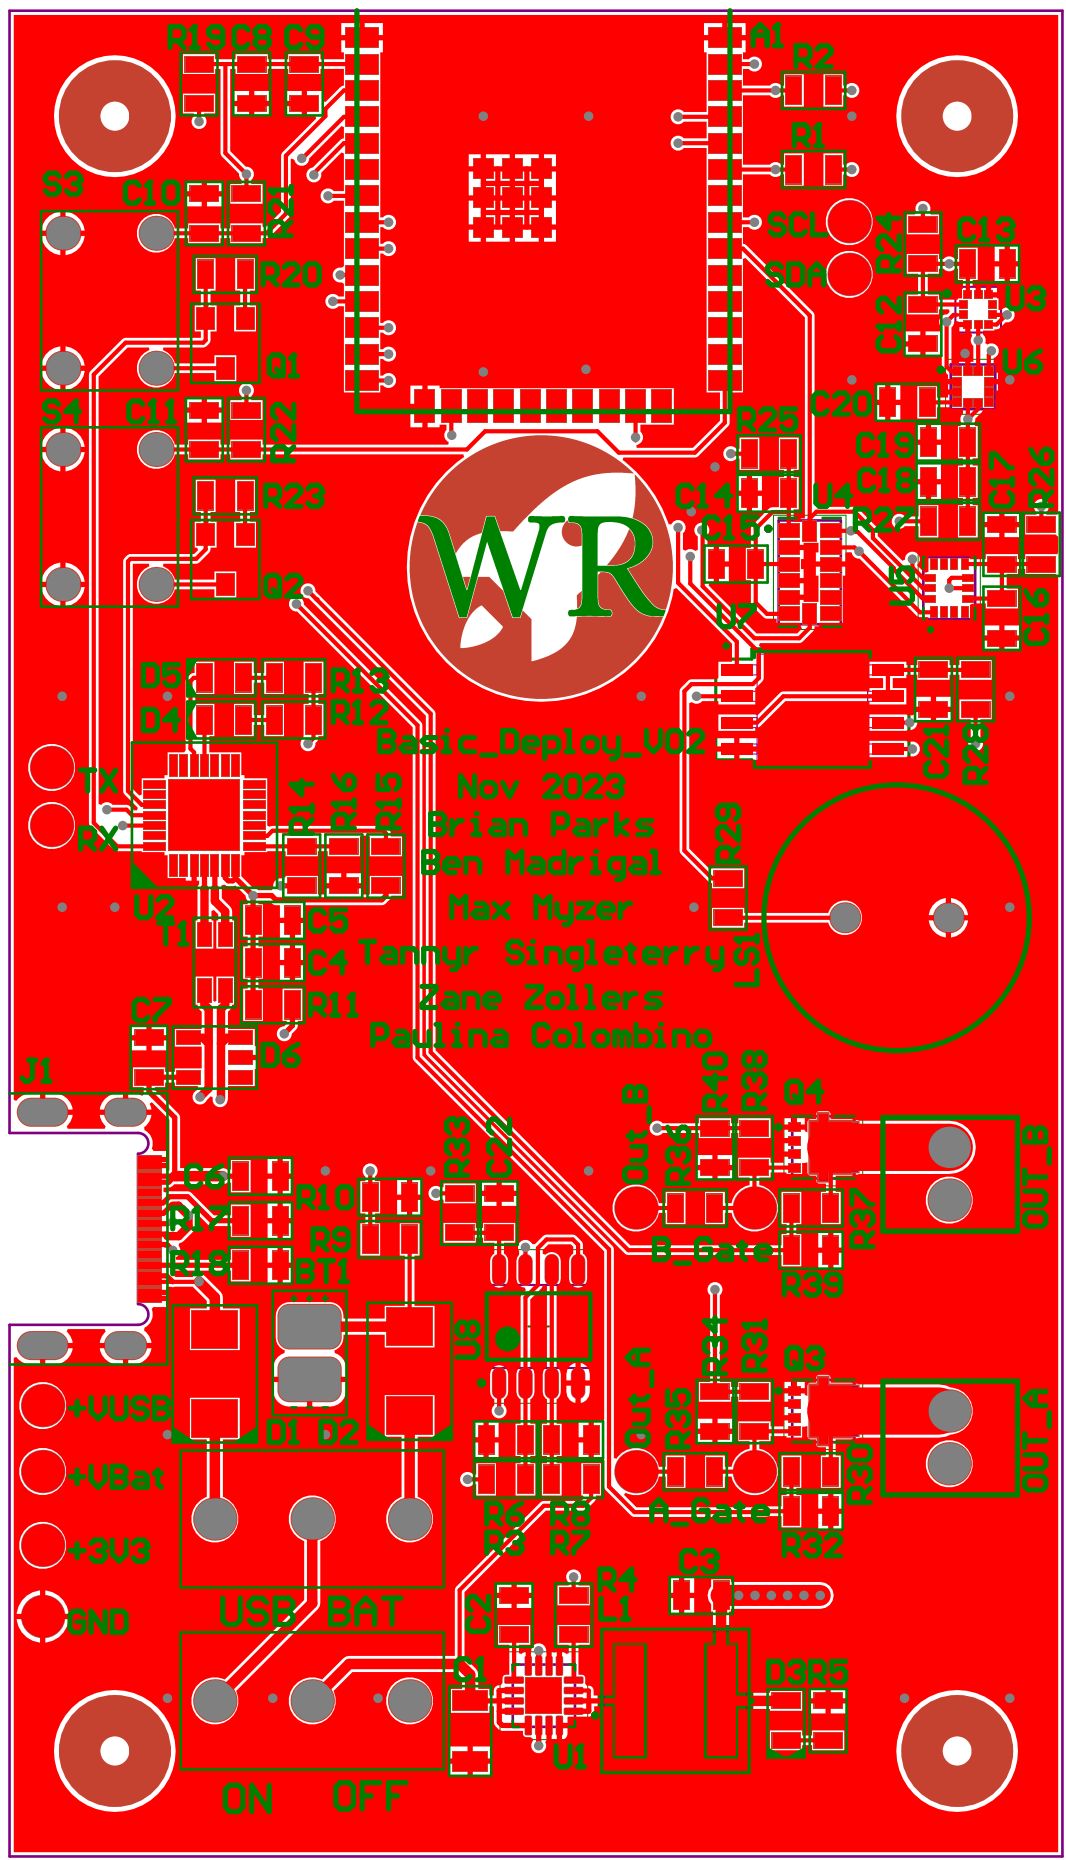
[picture p57: page 15]

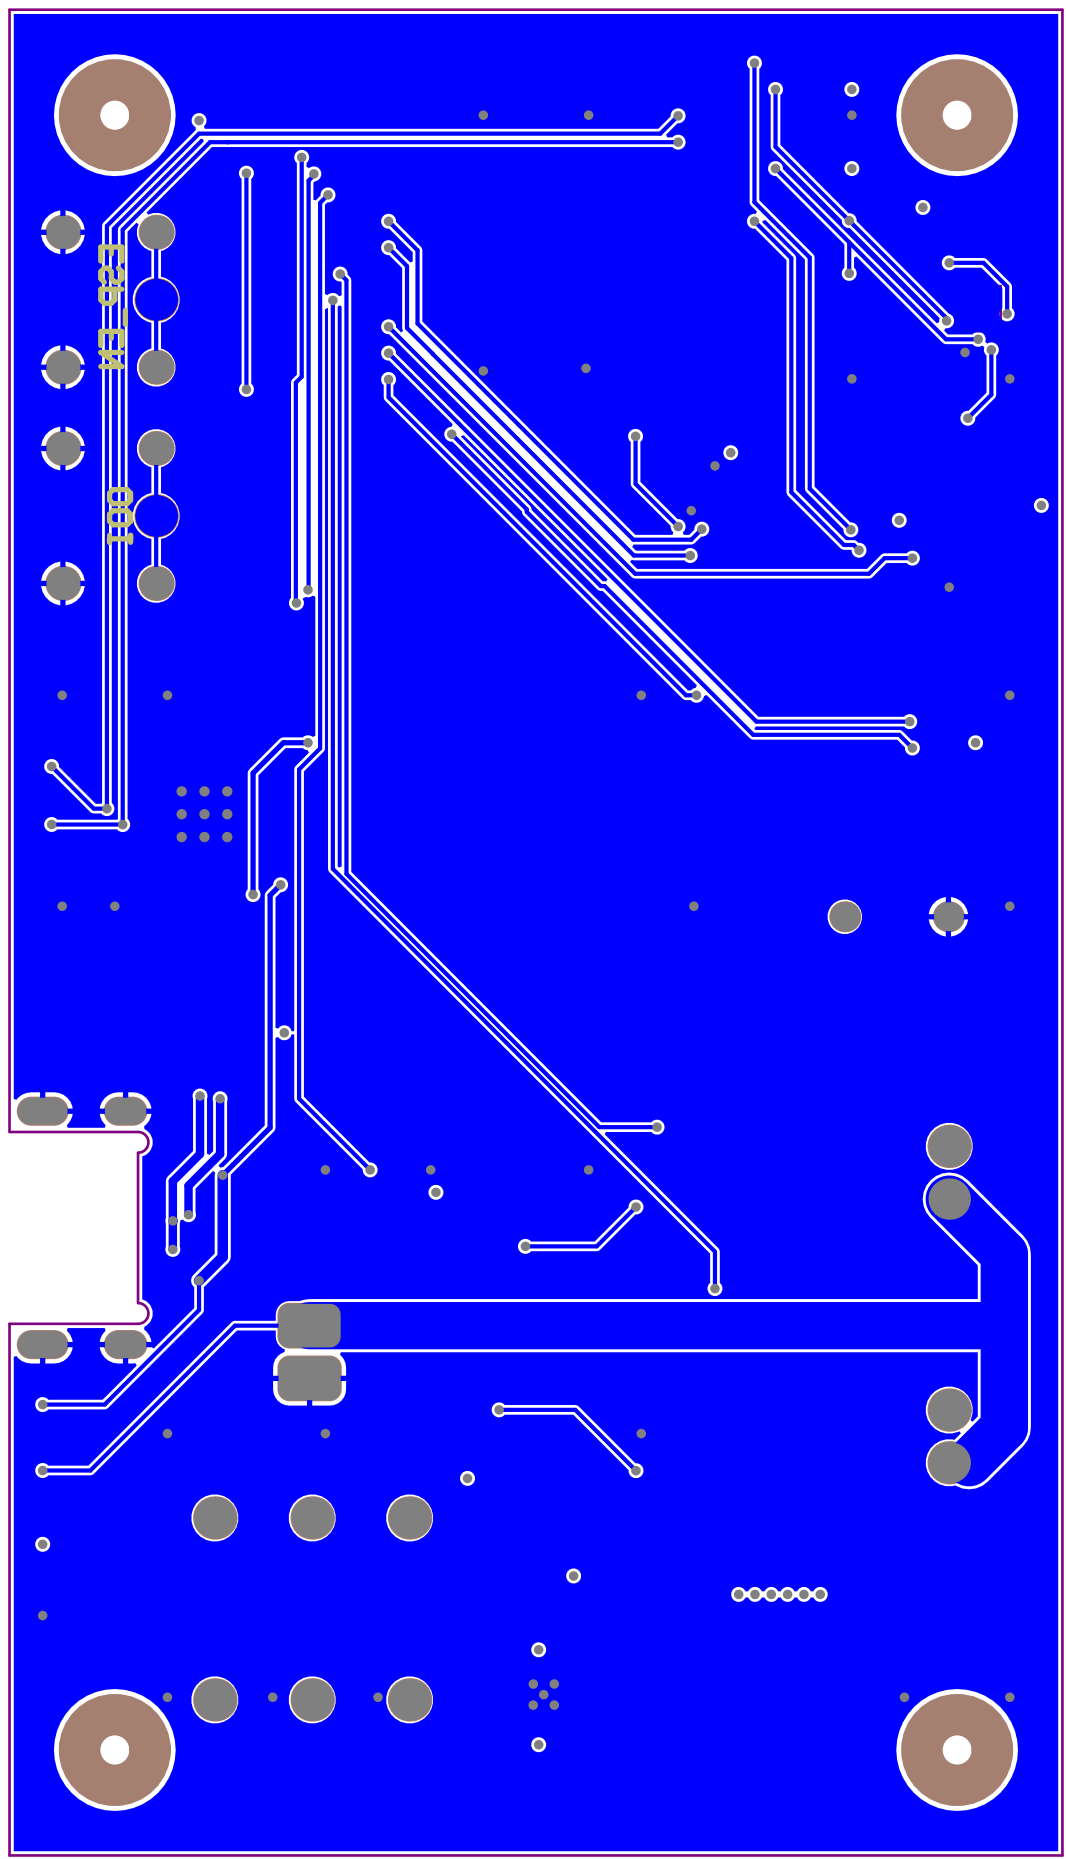
[picture p58: page 16]

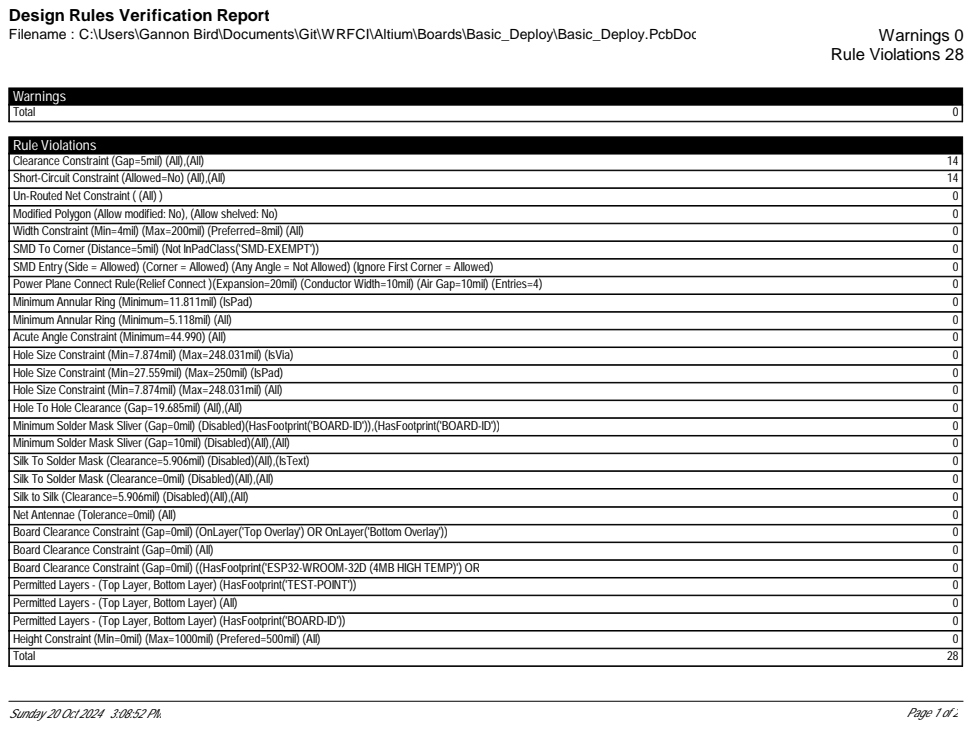
[picture p59: page 17]

Design Rules Verification Report

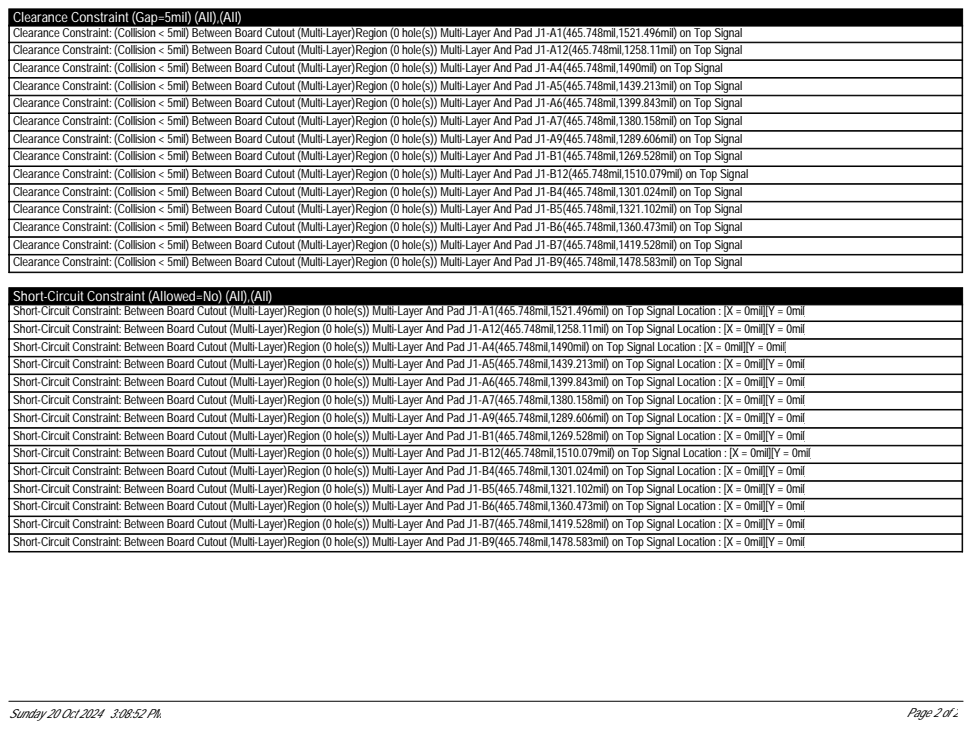
[picture p60: page 18]

Clearance Constraint (Gap=5mil) (All),(All)
Clearance Constraint: (Collision < 5mil) Between Board Cutout (Multi-Layer)Region (0 hole(s)) Multi-Layer And Pad J1-A1(465.748mil,1521.496mil) on Top Signal
Clearance Constraint: (Collision < 5mil) Between Board Cutout (Multi-Layer)Region (0 hole(s)) Multi-Layer And Pad J1-A12(465.748mil,1258.11mil) on Top Signal
Clearance Constraint: (Collision < 5mil) Between Board Cutout (Multi-Layer)Region (0 hole(s)) Multi-Layer And Pad J1-A4(465.748mil,1490mil) on Top Signal
Clearance Constraint: (Collision < 5mil) Between Board Cutout (Multi-Layer)Region (0 hole(s)) Multi-Layer And Pad J1-A5(465.748mil,1439.213mil) on Top Signal
Clearance Constraint: (Collision < 5mil) Between Board Cutout (Multi-Layer)Region (0 hole(s)) Multi-Layer And Pad J1-A6(465.748mil,1399.843mil) on Top Signal
Clearance Constraint: (Collision < 5mil) Between Board Cutout (Multi-Layer)Region (0 hole(s)) Multi-Layer And Pad J1-A7(465.748mil,1380.158mil) on Top Signal
Clearance Constraint: (Collision < 5mil) Between Board Cutout (Multi-Layer)Region (0 hole(s)) Multi-Layer And Pad J1-A9(465.748mil,1289.606mil) on Top Signal
Clearance Constraint: (Collision < 5mil) Between Board Cutout (Multi-Layer)Region (0 hole(s)) Multi-Layer And Pad J1-B1(465.748mil,1269.528mil) on Top Signal
Clearance Constraint: (Collision < 5mil) Between Board Cutout (Multi-Layer)Region (0 hole(s)) Multi-Layer And Pad J1-B12(465.748mil,1510.079mil) on Top Signal
Clearance Constraint: (Collision < 5mil) Between Board Cutout (Multi-Layer)Region (0 hole(s)) Multi-Layer And Pad J1-B4(465.748mil,1301.024mil) on Top Signal
Clearance Constraint: (Collision < 5mil) Between Board Cutout (Multi-Layer)Region (0 hole(s)) Multi-Layer And Pad J1-B5(465.748mil,1321.102mil) on Top Signal
Clearance Constraint: (Collision < 5mil) Between Board Cutout (Multi-Layer)Region (0 hole(s)) Multi-Layer And Pad J1-B6(465.748mil,1360.473mil) on Top Signal
Clearance Constraint: (Collision < 5mil) Between Board Cutout (Multi-Layer)Region (0 hole(s)) Multi-Layer And Pad J1-B7(465.748mil,1419.528mil) on Top Signal
Clearance Constraint: (Collision < 5mil) Between Board Cutout (Multi-Layer)Region (0 hole(s)) Multi-Layer And Pad J1-B9(465.748mil,1478.583mil) on Top Signal

Short-Circuit Constraint (Allowed=No) (All),(All)
Short-Circuit Constraint: Between Board Cutout (Multi-Layer)Region (0 hole(s)) Multi-Layer And Pad J1-A1(465.748mil,1521.496mil) on Top Signal Location : [X = 0mil][Y = 0mil]
Short-Circuit Constraint: Between Board Cutout (Multi-Layer)Region (0 hole(s)) Multi-Layer And Pad J1-A12(465.748mil,1258.11mil) on Top Signal Location : [X = 0mil][Y = 0mil]
Short-Circuit Constraint: Between Board Cutout (Multi-Layer)Region (0 hole(s)) Multi-Layer And Pad J1-A4(465.748mil,1490mil) on Top Signal Location : [X = 0mil][Y = 0mil]
Short-Circuit Constraint: Between Board Cutout (Multi-Layer)Region (0 hole(s)) Multi-Layer And Pad J1-A5(465.748mil,1439.213mil) on Top Signal Location : [X = 0mil][Y = 0mil]
Short-Circuit Constraint: Between Board Cutout (Multi-Layer)Region (0 hole(s)) Multi-Layer And Pad J1-A6(465.748mil,1399.843mil) on Top Signal Location : [X = 0mil][Y = 0mil]
Short-Circuit Constraint: Between Board Cutout (Multi-Layer)Region (0 hole(s)) Multi-Layer And Pad J1-A7(465.748mil,1380.158mil) on Top Signal Location : [X = 0mil][Y = 0mil]
Short-Circuit Constraint: Between Board Cutout (Multi-Layer)Region (0 hole(s)) Multi-Layer And Pad J1-A9(465.748mil,1289.606mil) on Top Signal Location : [X = 0mil][Y = 0mil]
Short-Circuit Constraint: Between Board Cutout (Multi-Layer)Region (0 hole(s)) Multi-Layer And Pad J1-B1(465.748mil,1269.528mil) on Top Signal Location : [X = 0mil][Y = 0mil]
Short-Circuit Constraint: Between Board Cutout (Multi-Layer)Region (0 hole(s)) Multi-Layer And Pad J1-B12(465.748mil,1510.079mil) on Top Signal Location : [X = 0mil][Y = 0mil]
Short-Circuit Constraint: Between Board Cutout (Multi-Layer)Region (0 hole(s)) Multi-Layer And Pad J1-B4(465.748mil,1301.024mil) on Top Signal Location : [X = 0mil][Y = 0mil]
Short-Circuit Constraint: Between Board Cutout (Multi-Layer)Region (0 hole(s)) Multi-Layer And Pad J1-B5(465.748mil,1321.102mil) on Top Signal Location : [X = 0mil][Y = 0mil]
Short-Circuit Constraint: Between Board Cutout (Multi-Layer)Region (0 hole(s)) Multi-Layer And Pad J1-B6(465.748mil,1360.473mil) on Top Signal Location : [X = 0mil][Y = 0mil]
Short-Circuit Constraint: Between Board Cutout (Multi-Layer)Region (0 hole(s)) Multi-Layer And Pad J1-B7(465.748mil,1419.528mil) on Top Signal Location : [X = 0mil][Y = 0mil]
Short-Circuit Constraint: Between Board Cutout (Multi-Layer)Region (0 hole(s)) Multi-Layer And Pad J1-B9(465.748mil,1478.583mil) on Top Signal Location : [X = 0mil][Y = 0mil]

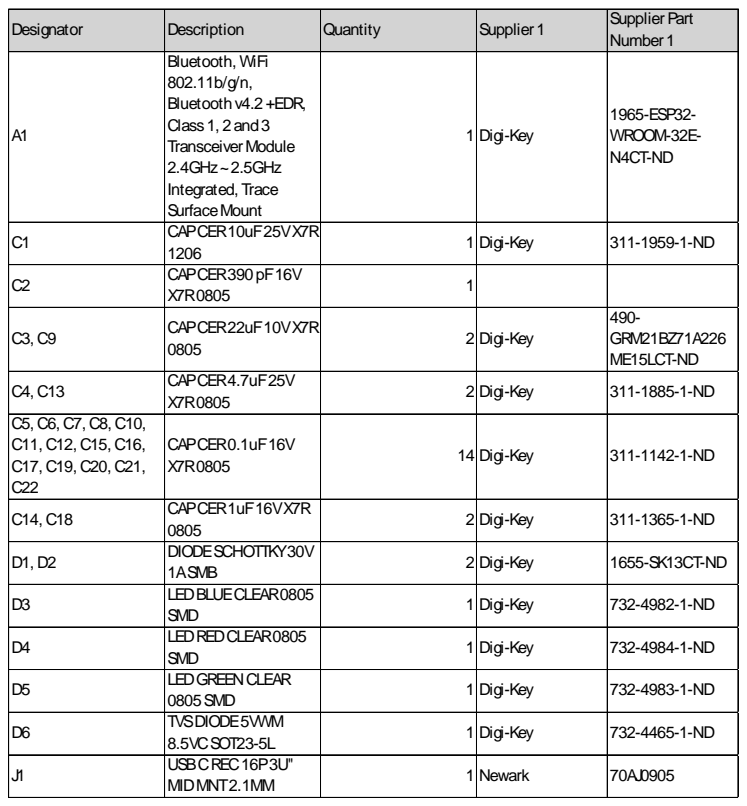
[picture p61: page 19]

Designator | Description | Quantity | Supplier 1 | SupplierPart Number 1

A1 | Bluetooth, WiFi 802.11b/g/n, Bluetoothv4.2 +EDR, Class1, 2and3 Transceiver Module 2.4GHz~2.5GHz Integrated, Trace SurfaceMount | 1 Digi-Key | | 1965-ESP32-WROOM-32E-N4CT-ND

C1 | CAPCER10uF25VX7R 1206 | 1 Digi-Key | | 311-1959-1-ND

C2 | CAPCER390pF16V X7R0805 | 1

C3, C9 | CAPCER22uF10VX7R 0805 | 2 Digi-Key | | 490-GRM21BZ71A226 ME15LCT-ND

C4, C13 | CAPCER4.7uF25V X7R0805 | 2 Digi-Key | | 311-1885-1-ND

C5, C6, C7, C8, C10, C11, C12, C15, C16, C17, C19, C20, C21, C22 | CAPCER0.1uF16V X7R0805 | 14 Digi-Key | | 311-1142-1-ND

C14, C18 | CAPCER1uF16VX7R 0805 | 2 Digi-Key | | 311-1365-1-ND

D1, D2 | DIODESCHOTTKY30V 1ASMB | 2 Digi-Key | | 1655-SK13CT-ND

D3 | LEDBLUECLEAR0805 SMD | 1 Digi-Key | | 732-4982-1-ND

D4 | LEDREDCLEAR0805 SMD | 1 Digi-Key | | 732-4984-1-ND

D5 | LEDGREENCLEAR 0805SMD | 1 Digi-Key | | 732-4983-1-ND

D6 | TVSDIODE5VWM 8.5VCSOT23-5L | 1 Digi-Key | | 732-4465-1-ND

J1 | USBCREC16P3U" MIDMNT2.1MM | 1 Newark | | 70AJ0905

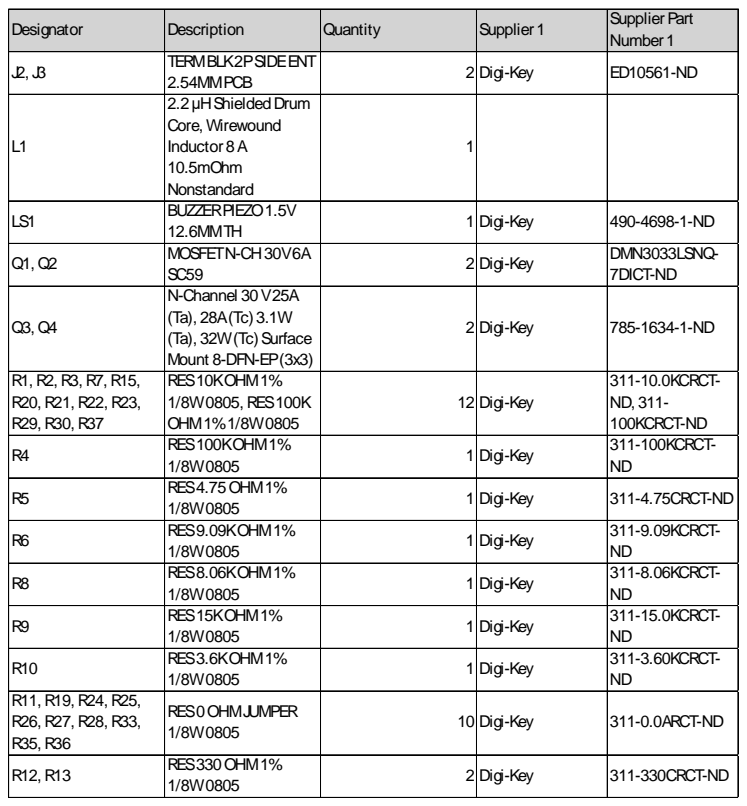
[picture p62: page 20]

Designator | Description | Quantity | Supplier 1 | SupplierPart Number 1

J2, J3 | TERMBLK2PSIDEENT 2.54MMPCB | 2 Digi-Key | | ED10561-ND

L1 | 2.2µHShieldedDrum Core, Wirewound Inductor 8A 10.5mOhm Nonstandard | 1

LS1 | BUZZERPIEZO1.5V 12.6MMTH | 1 Digi-Key | | 490-4698-1-ND

Q1, Q2 | MOSFETN-CH30V6A SC59 | 2 Digi-Key | | DMN3033LSNQ-7DICT-ND

Q3, Q4 | N-Channel 30V25A (Ta), 28A(Tc) 3.1W (Ta), 32W(Tc)Surface Mount 8-DFN-EP(3x3) | 2 Digi-Key | | 785-1634-1-ND

R1, R2, R3, R7, R15, R20, R21, R22, R23, R29, R30, R37 | RES10KOHM1% 1/8W0805, RES100K OHM1%1/8W0805 | 12 Digi-Key | | 311-10.0KCRCT-ND, 311-100KCRCT-ND

R4 | RES100KOHM1% 1/8W0805 | 1 Digi-Key | | 311-100KCRCT-ND

R5 | RES4.75OHM1% 1/8W0805 | 1 Digi-Key | | 311-4.75CRCT-ND

R6 | RES9.09KOHM1% 1/8W0805 | 1 Digi-Key | | 311-9.09KCRCT-ND

R8 | RES8.06KOHM1% 1/8W0805 | 1 Digi-Key | | 311-8.06KCRCT-ND

R9 | RES15KOHM1% 1/8W0805 | 1 Digi-Key | | 311-15.0KCRCT-ND

R10 | RES3.6KOHM1% 1/8W0805 | 1 Digi-Key | | 311-3.60KCRCT-ND

R11, R19, R24, R25, R26, R27, R28, R33, R35, R36 | RES0OHMJUMPER 1/8W0805 | 10 Digi-Key | | 311-0.0ARCT-ND

R12, R13 | RES330OHM1% 1/8W0805 | 2 Digi-Key | | 311-330CRCT-ND

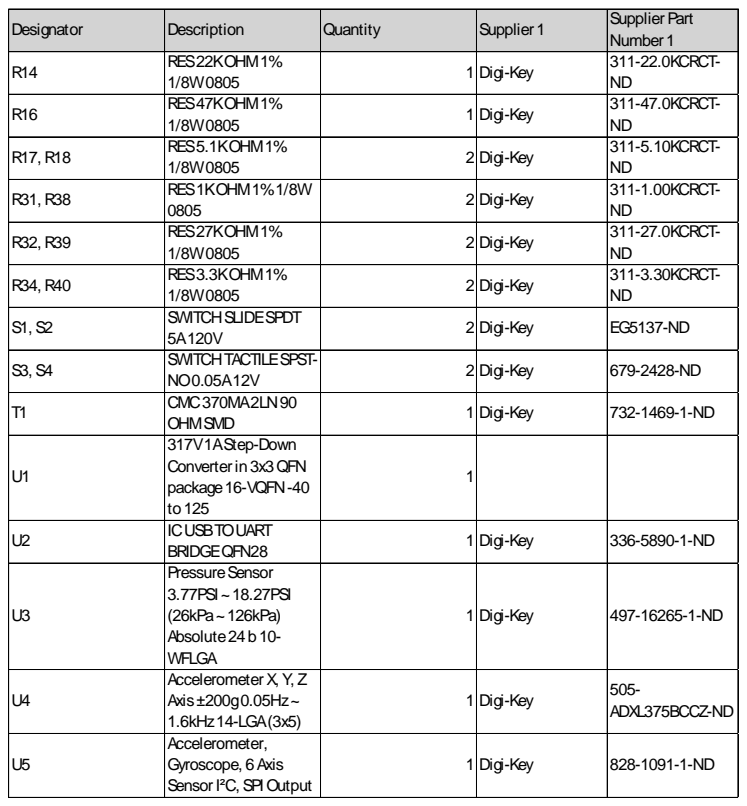
[picture p63: page 21]

Designator | Description | Quantity | Supplier 1 | SupplierPart Number 1

R14 | RES22KOHM1% 1/8W0805 | 1 Digi-Key | | 311-22.0KCRCT-ND

R16 | RES47KOHM1% 1/8W0805 | 1 Digi-Key | | 311-47.0KCRCT-ND

R17, R18 | RES5.1KOHM1% 1/8W0805 | 2 Digi-Key | | 311-5.10KCRCT-ND

R31, R38 | RES1KOHM1%1/8W 0805 | 2 Digi-Key | | 311-1.00KCRCT-ND

R32, R39 | RES27KOHM1% 1/8W0805 | 2 Digi-Key | | 311-27.0KCRCT-ND

R34, R40 | RES3.3KOHM1% 1/8W0805 | 2 Digi-Key | | 311-3.30KCRCT-ND

S1, S2 | SWITCHSLIDESPDT 5A120V | 2 Digi-Key | | EG5137-ND

S3, S4 | SWITCHTACTILESPST-NO0.05A12V | 2 Digi-Key | | 679-2428-ND

T1 | CMC370MA2LN90 OHMSMD | 1 Digi-Key | | 732-1469-1-ND

U1 | 317V1AStep-Down Converterin3x3QFN package16-VQFN-40 to125 | 1

U2 | ICUSBTOUART BRIDGEQFN28 | 1 Digi-Key | | 336-5890-1-ND

U3 | PressureSensor 3.77PSI~18.27PSI (26kPa~126kPa) Absolute24b10-WFLGA | 1 Digi-Key | | 497-16265-1-ND

U4 | AccelerometerX, Y, Z Axis±200g0.05Hz~ 1.6kHz14-LGA(3x5) | 1 Digi-Key | | 505-ADXL375BCCZ-ND

U5 | Accelerometer, Gyroscope, 6Axis SensorI²C, SPIOutput | 1 Digi-Key | | 828-1091-1-ND

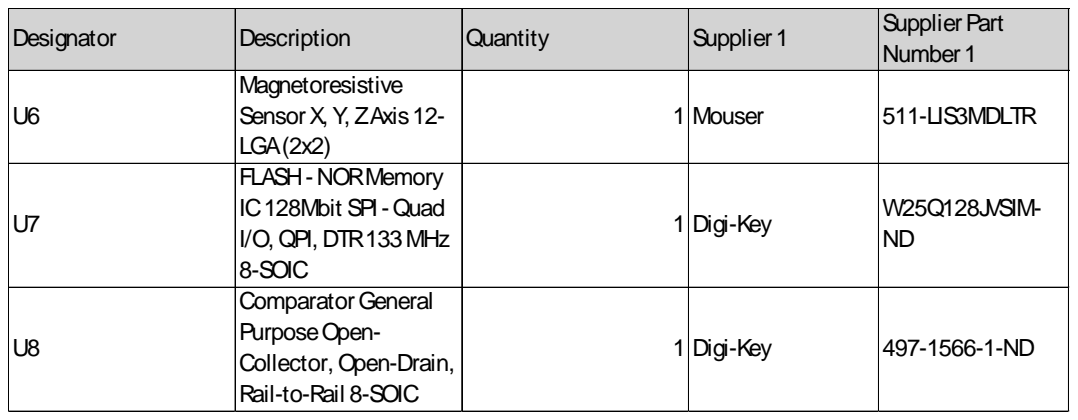
[picture p64: page 22]

Designator | Description | Quantity | Supplier 1 | SupplierPart Number 1

U6 | Magnetoresistive SensorX, Y, ZAxis12-LGA(2x2) | 1 Mouser | | 511-LIS3MDLTR

U7 | FLASH- NORMemory IC128Mbit SPI-Quad I/O, QPI, DTR133MHz 8-SOIC | 1 Digi-Key | | W25Q128JVSIM-ND

U8 | ComparatorGeneral PurposeOpen-Collector, Open-Drain, Rail-to-Rail 8-SOIC | 1 Digi-Key | | 497-1566-1-ND
