Tannyr-Singleterry/ECE590_SeniorDesign/Electronics/KiCAD/APG_Sensor_Test_Board/APG_Sensor_Test_Board.kicad_pcb

## KiCad design Electronics/KiCAD/APG_Sensor_Test_Board/APG_Sensor_Test_Board.kicad_pcb (2024-11-14)

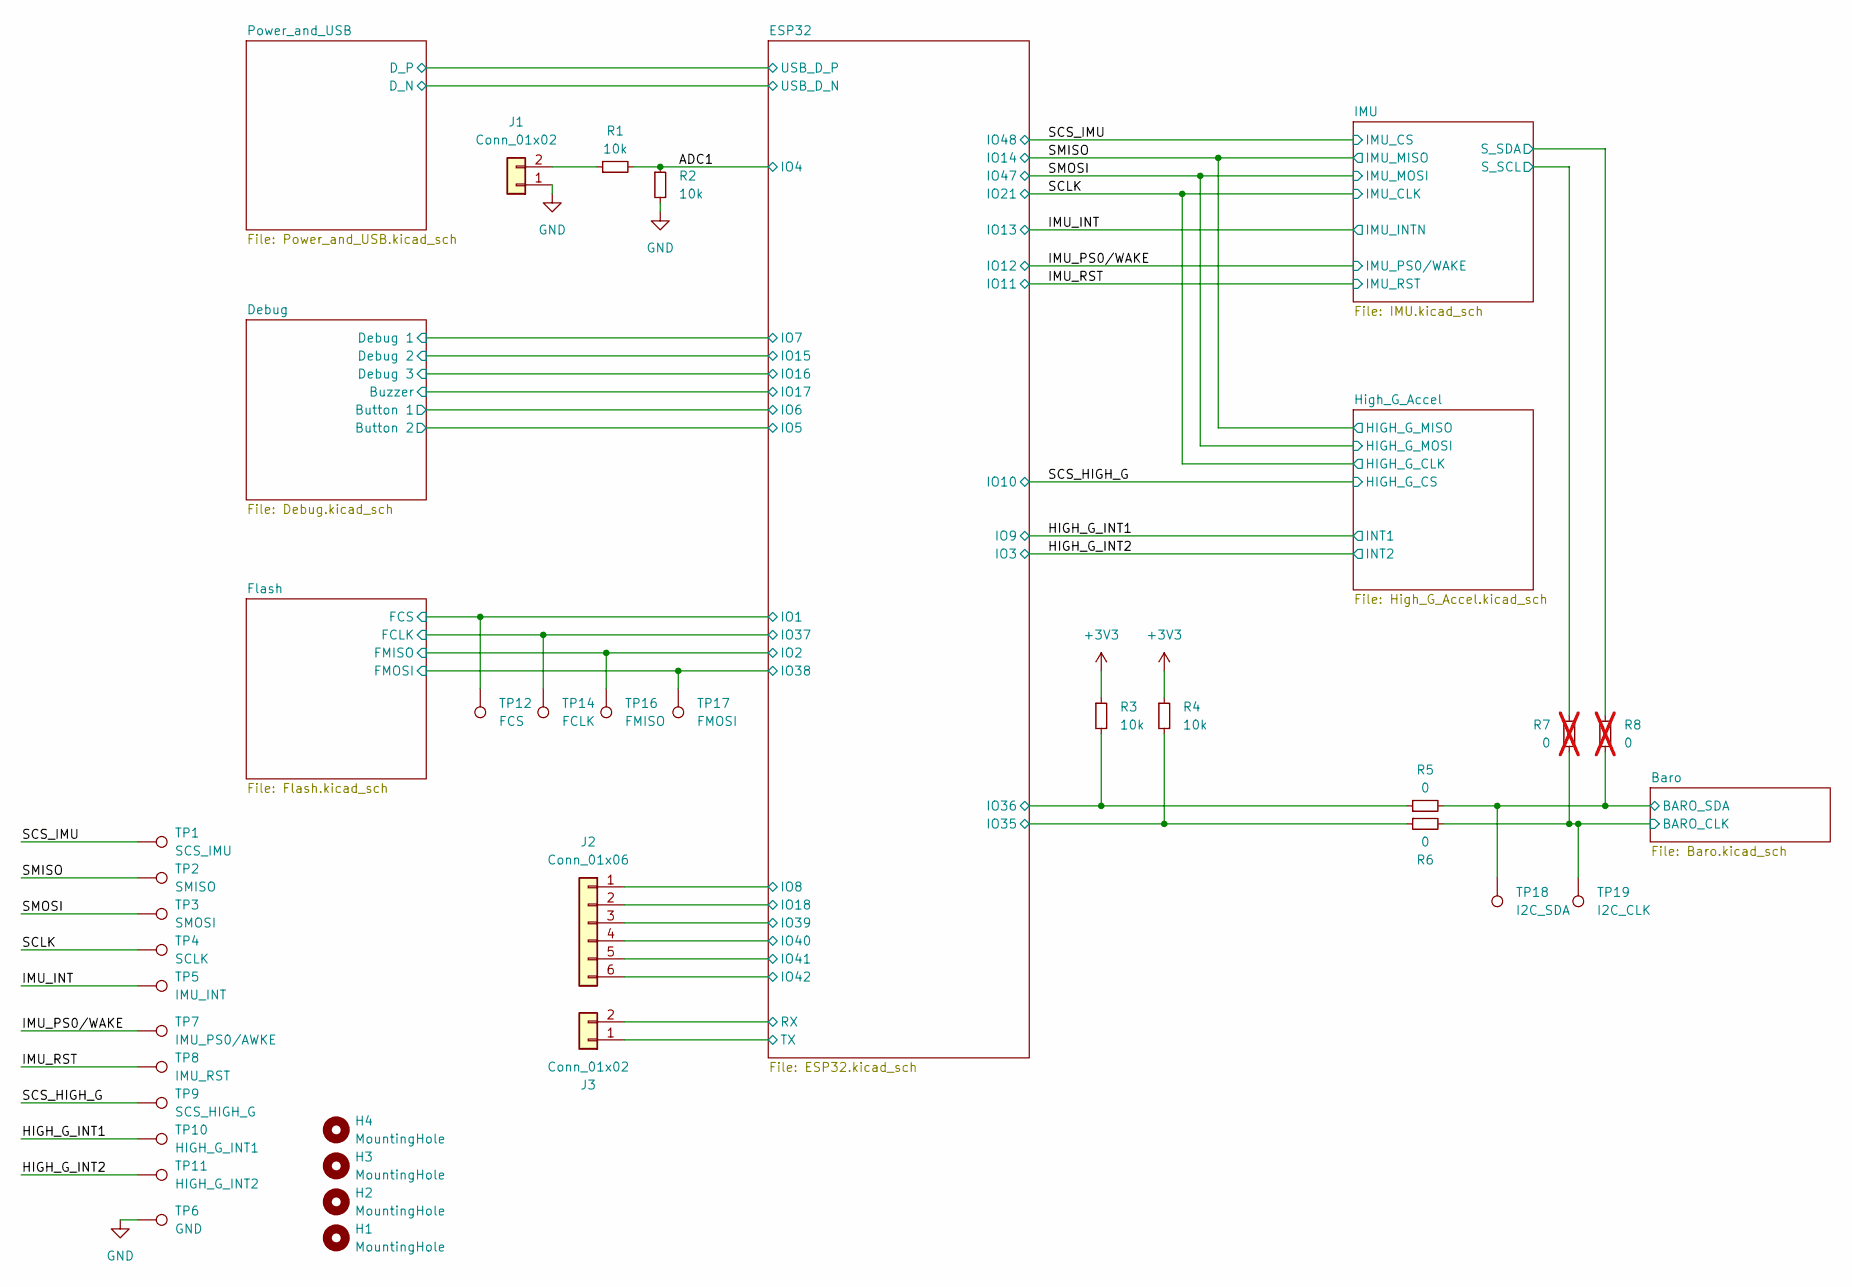
[picture p65: schematic APG_Sensor_Test_Board.kicad_sch]

Parts:
H1, H2, H3, H4: MountingHole; MountingHole_3.2mm_M3
J1, J3: Conn_01x02; PinHeader_1x02_P2.54mm_Vertical
J2: Conn_01x06; PinHeader_1x06_P2.54mm_Vertical
R1, R2, R3, R4: 10k; R_0603_1608Metric
R5, R6: 0; R_0603_1608Metric
R7, R8: 0; R_0603_1608Metric; not fitted
TP1: SCS_IMU; TestPoint_Pad_D1.0mm
TP2: SMISO; TestPoint_Pad_D1.0mm
TP3: SMOSI; TestPoint_Pad_D1.0mm
TP4: SCLK; TestPoint_Pad_D1.0mm
TP5: IMU_INT; TestPoint_Pad_D1.0mm
TP6: GND; TestPoint_Pad_D1.0mm
TP7: IMU_PS0/AWKE; TestPoint_Pad_D1.0mm
TP8: IMU_RST; TestPoint_Pad_D1.0mm
TP9: SCS_HIGH_G; TestPoint_Pad_D1.0mm
TP10: HIGH_G_INT1; TestPoint_Pad_D1.0mm
TP11: HIGH_G_INT2; TestPoint_Pad_D1.0mm
TP12: FCS; TestPoint_Pad_D1.0mm
TP14: FCLK; TestPoint_Pad_D1.0mm
TP16: FMISO; TestPoint_Pad_D1.0mm
TP17: FMOSI; TestPoint_Pad_D1.0mm
TP18: I2C_SDA; TestPoint_Pad_D1.0mm
TP19: I2C_CLK; TestPoint_Pad_D1.0mm

Connections:
+3V3: R3.1, R4.1; also elsewhere on the board
/ADC1: R1.2, R2.1; also elsewhere on the board
/Baro/BARO_CLK: R6.2, R7.1, TP19.1; also elsewhere on the board
/Baro/BARO_SDA: R5.2, R8.1, TP18.1; also elsewhere on the board
/ESP32/IO1: TP12.1; also elsewhere on the board
/ESP32/IO2: TP16.1; also elsewhere on the board
/ESP32/IO8: J2.1; also elsewhere on the board
/ESP32/IO18: J2.2; also elsewhere on the board
/ESP32/IO35: R4.2, R6.1; also elsewhere on the board
/ESP32/IO36: R3.2, R5.1; also elsewhere on the board
/ESP32/IO37: TP14.1; also elsewhere on the board
/ESP32/IO38: TP17.1; also elsewhere on the board
/ESP32/IO39: J2.3; also elsewhere on the board
/ESP32/IO40: J2.4; also elsewhere on the board
/ESP32/IO41: J2.5; also elsewhere on the board
/ESP32/IO42: J2.6; also elsewhere on the board
/ESP32/RX: J3.2; also elsewhere on the board
/ESP32/TX: J3.1; also elsewhere on the board
/HIGH_G_INT1: TP10.1; also elsewhere on the board
/HIGH_G_INT2: TP11.1; also elsewhere on the board
/IMU/S_SCL: R7.2; also elsewhere on the board
/IMU/S_SDA: R8.2; also elsewhere on the board
/IMU_INT: TP5.1; also elsewhere on the board
/IMU_PS0/WAKE: TP7.1; also elsewhere on the board
/IMU_RST: TP8.1; also elsewhere on the board
/SCLK: TP4.1; also elsewhere on the board
/SCS_HIGH_G: TP9.1; also elsewhere on the board
/SCS_IMU: TP1.1; also elsewhere on the board
/SMISO: TP2.1; also elsewhere on the board
/SMOSI: TP3.1; also elsewhere on the board
GND: J1.1, R2.2, TP6.1; also elsewhere on the board
unnamed: J1.2, R1.1

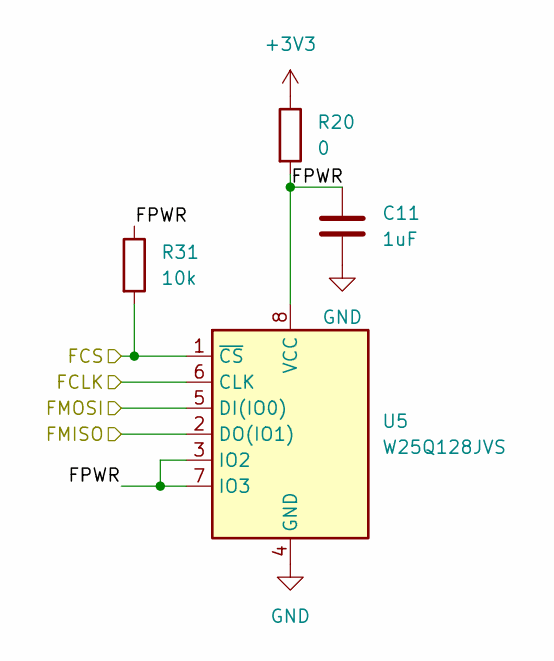
[picture p66: schematic Flash.kicad_sch]

Parts:
C11: 1uF; C_0603_1608Metric
R20: 0; R_0603_1608Metric
R31: 10k; R_0603_1608Metric
U5: W25Q128JVS; SOIC-8_5.23x5.23mm_P1.27mm; JLCPCB C97521

Connections:
+3V3: R20.1; also elsewhere on the board
/ESP32/IO1: R31.2, U5.1 (~CS); also elsewhere on the board
/ESP32/IO2: U5.2 (DO(IO1)); also elsewhere on the board
/ESP32/IO37: U5.6 (CLK); also elsewhere on the board
/ESP32/IO38: U5.5 (DI(IO0)); also elsewhere on the board
/Flash/FPWR: C11.1, R20.2, R31.1, U5.3 (IO2), U5.7 (IO3), U5.8 (VCC)
GND: C11.2, U5.4 (GND); also elsewhere on the board

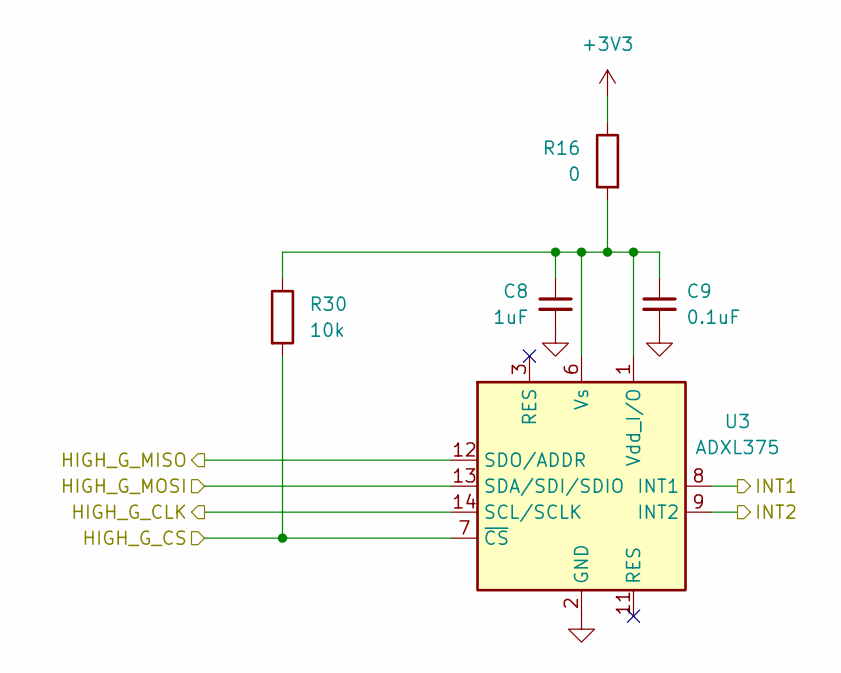
[picture p67: schematic High_G_Accel.kicad_sch]

Parts:
C8: 1uF; C_0603_1608Metric
C9: 0.1uF; C_0603_1608Metric
R16: 0; R_0603_1608Metric
R30: 10k; R_0603_1608Metric
U3: ADXL375; LGA-14_3x5mm_P0.8mm_LayoutBorder1x6y; JLCPCB C481898

Connections:
+3V3: R16.1; also elsewhere on the board
/HIGH_G_INT1: U3.8 (INT1); also elsewhere on the board
/HIGH_G_INT2: U3.9 (INT2); also elsewhere on the board
/SCLK: U3.14 (SCL/SCLK); also elsewhere on the board
/SCS_HIGH_G: R30.2, U3.7 (~CS); also elsewhere on the board
/SMISO: U3.12 (SDO/ADDR); also elsewhere on the board
/SMOSI: U3.13 (SDA/SDI/SDIO); also elsewhere on the board
GND: C8.2, C9.2, U3.2 (GND), U3.4 (GND), U3.5 (GND); also elsewhere on the board
unnamed: C8.1, C9.1, R16.2, R30.1, U3.1 (Vdd_I/O), U3.6 (Vs)

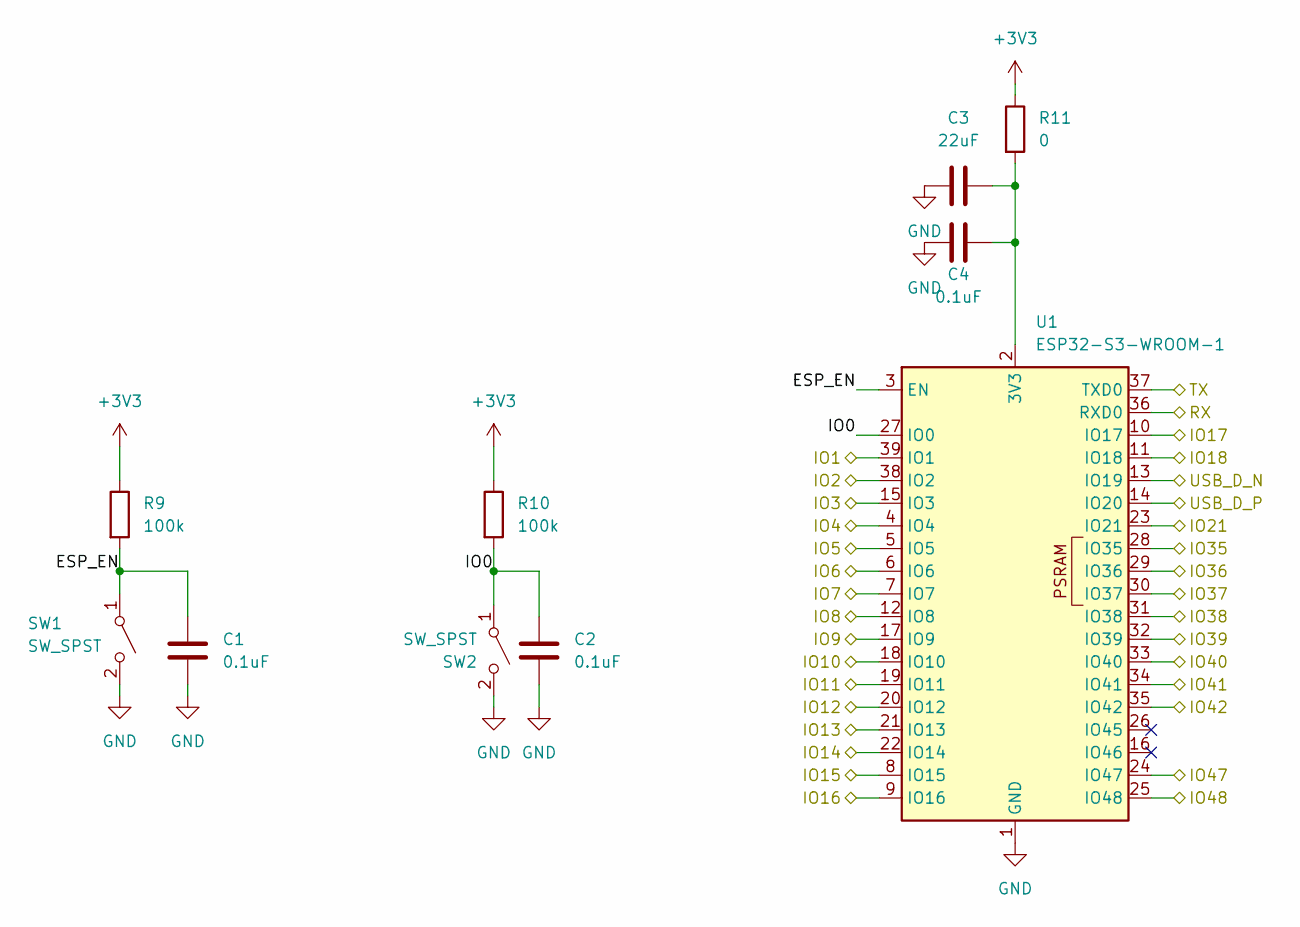
[picture p68: schematic ESP32.kicad_sch]

Parts:
C1, C2, C4: 0.1uF; C_0603_1608Metric
C3: 22uF; C_0603_1608Metric
R9, R10: 100k; R_0603_1608Metric
R11: 0; R_0603_1608Metric
SW1, SW2: SW_SPST; SW_PUSH_6mm_H5mm
U1: ESP32-S3-WROOM-1; JLCPCB C2913198

Connections:
+3V3: R9.1, R10.1, R11.1; also elsewhere on the board
/ADC1: U1.4 (IO4); also elsewhere on the board
/Debug/Button 1: U1.6 (IO6); also elsewhere on the board
/Debug/Button 2: U1.5 (IO5); also elsewhere on the board
/Debug/Buzzer: U1.10 (IO17); also elsewhere on the board
/Debug/Debug 1: U1.7 (IO7); also elsewhere on the board
/Debug/Debug 2: U1.8 (IO15); also elsewhere on the board
/Debug/Debug 3: U1.9 (IO16); also elsewhere on the board
/ESP32/ESP_EN: C1.1, R9.2, SW1.1 (A), U1.3 (EN)
/ESP32/IO0: C2.1, R10.2, SW2.1 (A), U1.27 (IO0)
/ESP32/IO1: U1.39 (IO1); also elsewhere on the board
/ESP32/IO2: U1.38 (IO2); also elsewhere on the board
/ESP32/IO8: U1.12 (IO8); also elsewhere on the board
/ESP32/IO18: U1.11 (IO18); also elsewhere on the board
/ESP32/IO35: U1.28 (IO35); also elsewhere on the board
/ESP32/IO36: U1.29 (IO36); also elsewhere on the board
/ESP32/IO37: U1.30 (IO37); also elsewhere on the board
/ESP32/IO38: U1.31 (IO38); also elsewhere on the board
/ESP32/IO39: U1.32 (IO39); also elsewhere on the board
/ESP32/IO40: U1.33 (IO40); also elsewhere on the board
/ESP32/IO41: U1.34 (IO41); also elsewhere on the board
/ESP32/IO42: U1.35 (IO42); also elsewhere on the board
/ESP32/RX: U1.36 (RXD0); also elsewhere on the board
/ESP32/TX: U1.37 (TXD0); also elsewhere on the board
/ESP32/USB_D_N: U1.13 (IO19); also elsewhere on the board
/ESP32/USB_D_P: U1.14 (IO20); also elsewhere on the board
/HIGH_G_INT1: U1.17 (IO9); also elsewhere on the board
/HIGH_G_INT2: U1.15 (IO3); also elsewhere on the board
/IMU_INT: U1.21 (IO13); also elsewhere on the board
/IMU_PS0/WAKE: U1.20 (IO12); also elsewhere on the board
/IMU_RST: U1.19 (IO11); also elsewhere on the board
/SCLK: U1.23 (IO21); also elsewhere on the board
/SCS_HIGH_G: U1.18 (IO10); also elsewhere on the board
/SCS_IMU: U1.25 (IO48); also elsewhere on the board
/SMISO: U1.22 (IO14); also elsewhere on the board
/SMOSI: U1.24 (IO47); also elsewhere on the board
GND: C1.2, C2.2, C3.1, C4.1, SW1.2 (B), SW2.2 (B), U1.1 (GND), U1.40 (GND), U1.41 (GND); also elsewhere on the board
unnamed: C3.2, C4.2, R11.2, U1.2 (3V3)

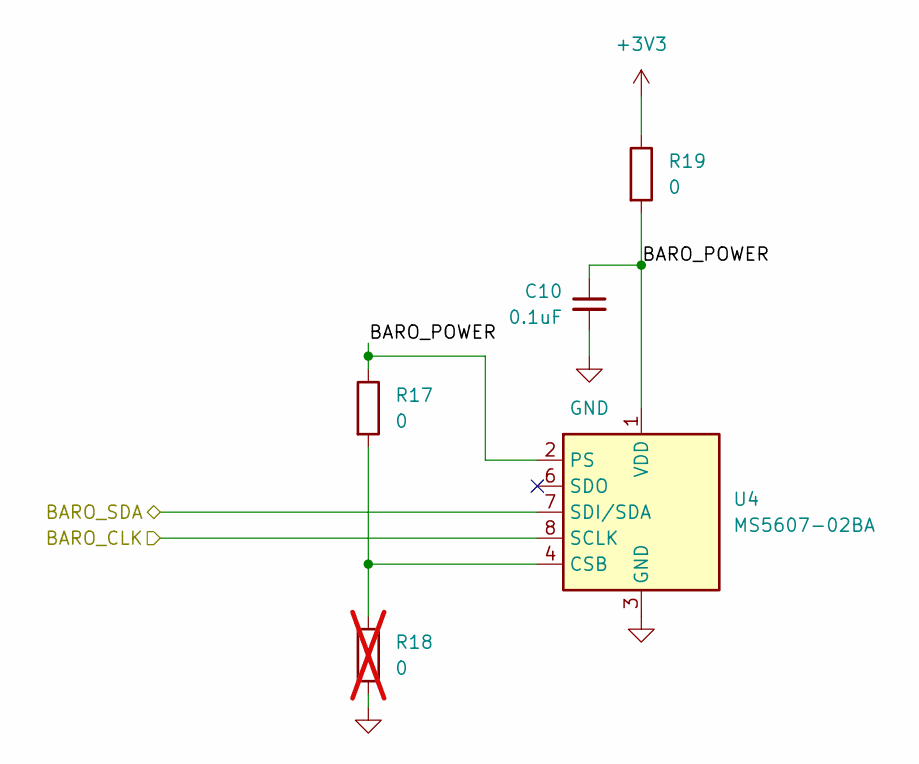
[picture p69: schematic Baro.kicad_sch]

Parts:
C10: 0.1uF; C_0603_1608Metric
R17, R19: 0; R_0603_1608Metric
R18: 0; R_0603_1608Metric; not fitted
U4: MS5607-02BA; LGA-8_3x5mm_P1.25mm; JLCPCB C97627

Connections:
+3V3: R19.1; also elsewhere on the board
/Baro/BARO_CLK: U4.8 (SCLK); also elsewhere on the board
/Baro/BARO_POWER: C10.1, R17.1, R19.2, U4.1 (VDD), U4.2 (PS)
/Baro/BARO_SDA: U4.7 (SDI/SDA); also elsewhere on the board
GND: C10.2, R18.2, U4.3 (GND); also elsewhere on the board
unnamed: R17.2, R18.1, U4.4 (CSB), U4.5 (CSB)

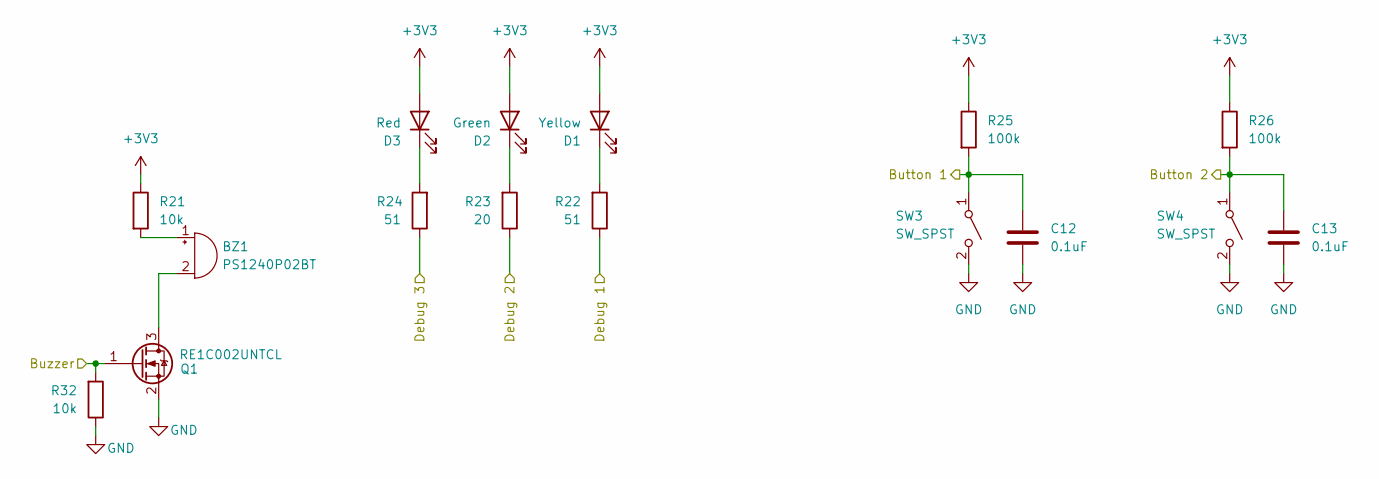
[picture p70: schematic Debug.kicad_sch]

Parts:
BZ1: PS1240P02BT; Buzzer_TDK_PS1240P02BT_D12.2mm_H6.5mm
C12, C13: 0.1uF; C_0603_1608Metric
D1: Yellow; LED_0805_2012Metric; JLCPCB C2296
D2: Green; LED_0805_2012Metric; JLCPCB C2297
D3: Red; LED_0805_2012Metric; JLCPCB C84256
Q1: RE1C002UNTCL; SOT-416; JLCPCB C509959
R21, R32: 10k; R_0603_1608Metric
R22, R24: 51; R_0603_1608Metric
R23: 20; R_0603_1608Metric
R25, R26: 100k; R_0603_1608Metric
SW3, SW4: SW_SPST; SW_PUSH_6mm_H5mm

Connections:
+3V3: D1.2 (A), D2.2 (A), D3.2 (A), R21.1, R25.1, R26.1; also elsewhere on the board
/Debug/Button 1: C12.1, R25.2, SW3.1 (A); also elsewhere on the board
/Debug/Button 2: C13.1, R26.2, SW4.1 (A); also elsewhere on the board
/Debug/Buzzer: Q1.1 (G), R32.2; also elsewhere on the board
/Debug/Debug 1: R22.1; also elsewhere on the board
/Debug/Debug 2: R23.1; also elsewhere on the board
/Debug/Debug 3: R24.1; also elsewhere on the board
GND: C12.2, C13.2, Q1.2 (S), R32.1, SW3.2 (B), SW4.2 (B); also elsewhere on the board
unnamed: BZ1.1 (+), R21.2
unnamed: BZ1.2 (-), Q1.3 (D)
unnamed: D1.1 (K), R22.2
unnamed: D2.1 (K), R23.2
unnamed: D3.1 (K), R24.2

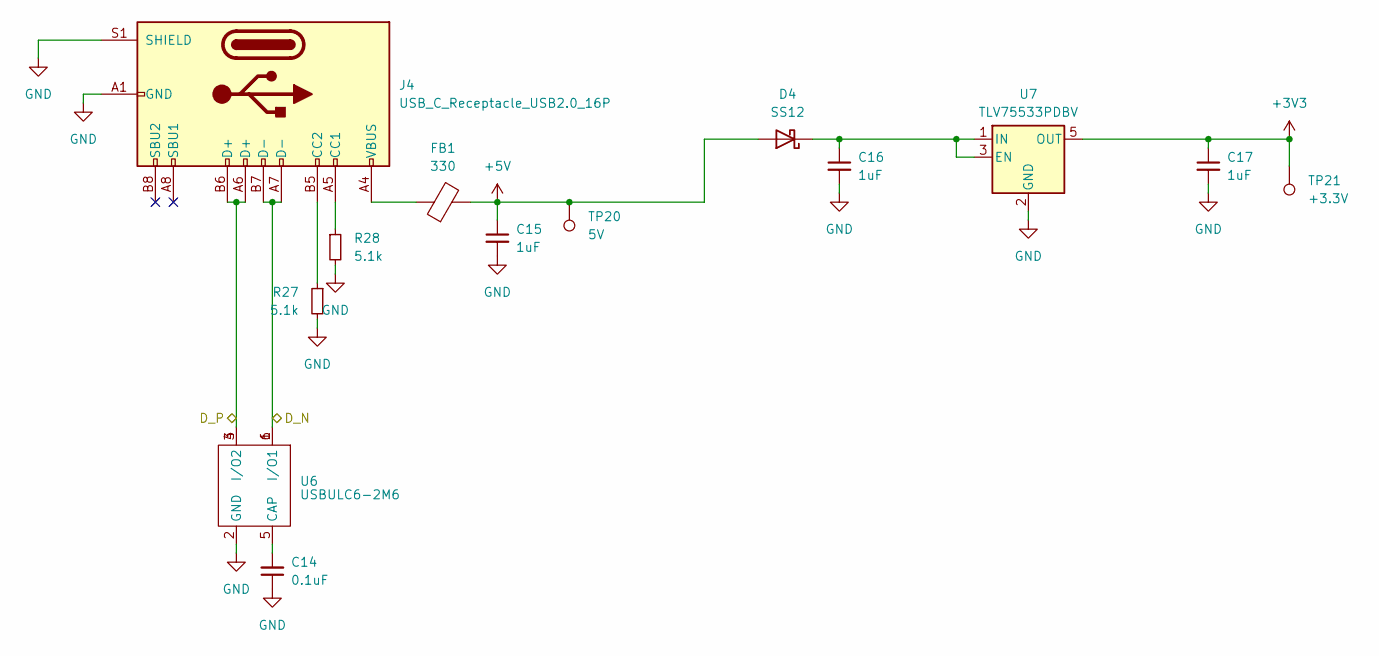
[picture p71: schematic Power_and_USB.kicad_sch]

Parts:
C14: 0.1uF; C_0603_1608Metric
C15, C16, C17: 1uF; C_0603_1608Metric
D4: SS12; D_SMA; JLCPCB C184027
FB1: 330; R_0805_2012Metric; JLCPCB C76819
J4: USB_C_Receptacle_USB2.0_16P; USB_C_Receptacle_GCT_USB4105-xx-A_16P_TopMnt_Horizontal; DigiKey Part # USB4105-GF-A
R27, R28: 5.1k; R_0603_1608Metric
TP20: 5V; TestPoint_Pad_D1.0mm
TP21: +3.3V; TestPoint_Pad_D1.0mm
U6: USBULC6-2M6; ST_UQFN-6L_1.5x1.7mm_P0.5mm; JLCPCB C672213
U7: TLV75533PDBV; SOT-23-5; JLCPCB C404027

Connections:
+3V3: C17.1, TP21.1, U7.5 (OUT); also elsewhere on the board
+5V: C15.1, D4.2 (A), FB1.2, TP20.1; also elsewhere on the board
/ESP32/USB_D_N: J4.A7 (D-), J4.B7 (D-), U6.1 (I/O1), U6.6 (I/O1); also elsewhere on the board
/ESP32/USB_D_P: J4.A6 (D+), J4.B6 (D+), U6.3 (I/O2), U6.4 (I/O2); also elsewhere on the board
GND: C14.1, C15.2, C16.2, C17.2, J4.A1 (GND), J4.A12 (GND), J4.B1 (GND), J4.B12 (GND), J4.S1 (SHIELD), R27.2, R28.2, U6.2 (GND), U7.2 (GND); also elsewhere on the board
unnamed: C16.1, D4.1 (K), U7.1 (IN), U7.3 (EN)
unnamed: FB1.1, J4.A4 (VBUS), J4.A9 (VBUS), J4.B4 (VBUS), J4.B9 (VBUS)
unnamed: J4.A5 (CC1), R28.1
unnamed: J4.B5 (CC2), R27.1
unnamed: C14.2, U6.5 (CAP)

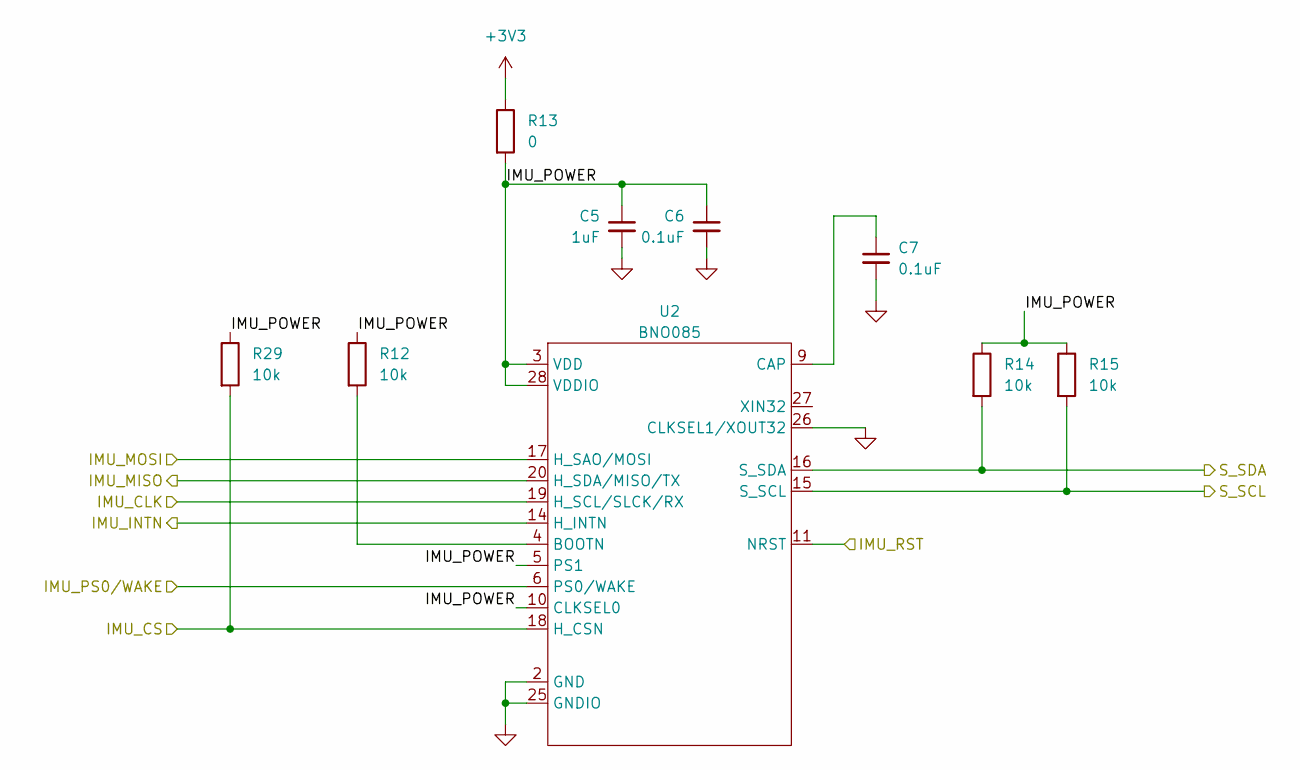
[picture p72: schematic IMU.kicad_sch]

Parts:
C5: 1uF; C_0603_1608Metric
C6, C7: 0.1uF; C_0603_1608Metric
R12, R14, R15, R29: 10k; R_0603_1608Metric
R13: 0; R_0603_1608Metric
U2: BNO085; LGA-28_5.2x3.8mm_P0.5mm

Connections:
+3V3: R13.1; also elsewhere on the board
/IMU/IMU_POWER: C5.1, C6.1, R12.1, R13.2, R14.1, R15.1, R29.1, U2.3 (VDD), U2.5 (PS1), U2.10 (CLKSEL0), U2.28 (VDDIO)
/IMU/S_SCL: R15.2, U2.15 (S_SCL); also elsewhere on the board
/IMU/S_SDA: R14.2, U2.16 (S_SDA); also elsewhere on the board
/IMU_INT: U2.14 (H_INTN); also elsewhere on the board
/IMU_PS0/WAKE: U2.6 (PS0/WAKE); also elsewhere on the board
/IMU_RST: U2.11 (NRST); also elsewhere on the board
/SCLK: U2.19 (H_SCL/SLCK/RX); also elsewhere on the board
/SCS_IMU: R29.2, U2.18 (H_CSN); also elsewhere on the board
/SMISO: U2.20 (H_SDA/MISO/TX); also elsewhere on the board
/SMOSI: U2.17 (H_SAO/MOSI); also elsewhere on the board
GND: C5.2, C6.2, C7.2, U2.2 (GND), U2.25 (GNDIO), U2.26 (CLKSEL1/XOUT32); also elsewhere on the board
unnamed: R12.2, U2.4 (BOOTN)
unnamed: C7.1, U2.9 (CAP)

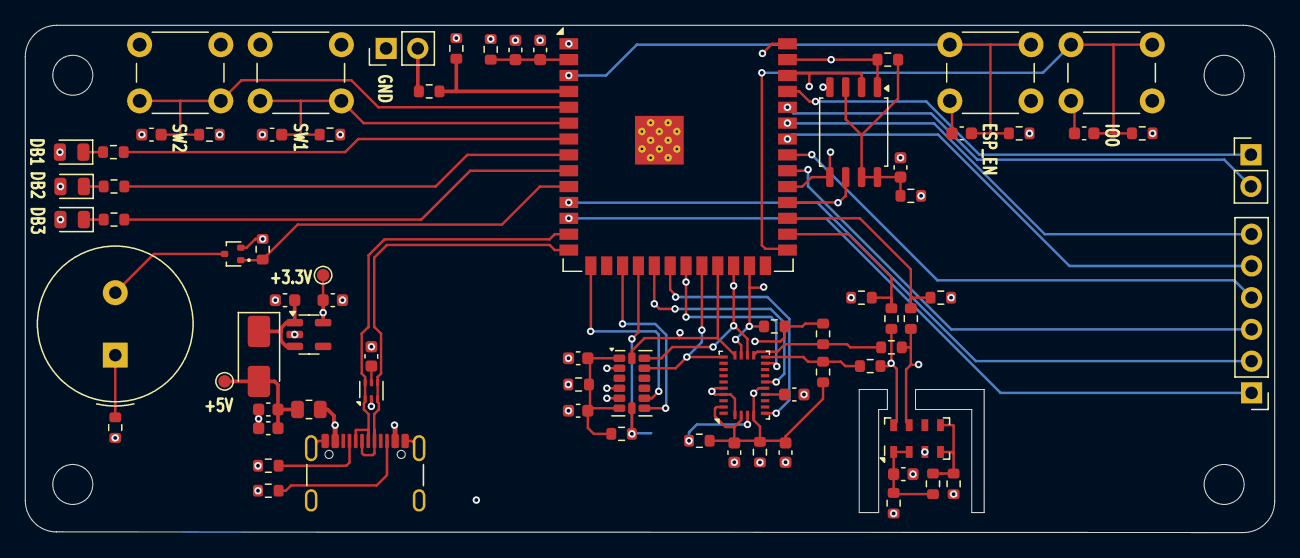
[picture p73: board APG_Sensor_Test_Board.kicad_pcb from above]

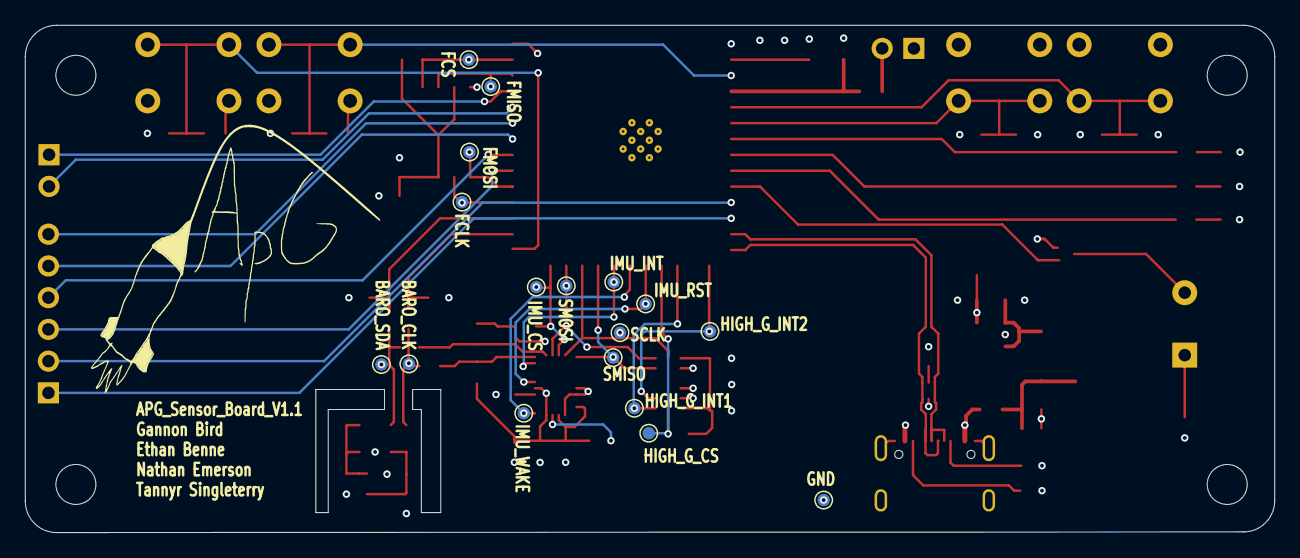
[picture p74: board APG_Sensor_Test_Board.kicad_pcb from below]

Board: 4 copper layers, 100.0 x 40.6 mm, 95 parts (17 on the bottom side), 61 nets.

Other parts of the board:
C14#2: 1u; C_0603_1608Metric

Their connections:
+5V: C14#2.1; also elsewhere on the board
GND: C14#2.2; also elsewhere on the board
