Tannyr-Singleterry/ECE590_SeniorDesign/(commit log)

2024-09-12 Added RFA in Documnets
    [Flight Computer Budget.xlsx]
2024-09-27 added presentation shell and empty, formatted excel sheets
    [APG_SrDesCombinedSheet.xlsx]
2024-10-01 Created KiCAD Project for first board
    [APG_Sensor_Test_Board.kicad_pcb, APG_Sensor_Test_Board.kicad_sch]
2024-10-01 Created component selection Excel Sheet
    [Component_Selection.xlsx]
2024-10-01 added some compoents to component select
    [Component_Selection.xlsx]
2024-10-01 fixed JLC extended part Fee
    [Component_Selection.xlsx]
2024-10-03 Pushing what i have so far
    [APG_SrDesCombinedSheet.xlsx]
2024-10-03 final edits before meeting tomorrow
    [APG_SrDesCombinedSheet.xlsx]
2024-10-03 added 3 things to da excel sheet
    [APG_SrDesCombinedSheet.xlsx]
2024-10-03 CDR Tables done yay
    [APG_SrDesCombinedSheet.xlsx]
2024-10-03 stuff i have done
    [APG_SrDesCombinedSheet.xlsx]
2024-10-03 changed baro
    [Component_Selection.xlsx]
2024-10-07 meeting edits
    [APG_SrDesCombinedSheet.xlsx]
2024-10-20 picked High G accelrometer
    [Component_Selection.xlsx]
2024-10-20 Added Flash
    [Component_Selection.xlsx]
2024-10-20 Added gantt chart
    [Gantt.xlsx]
2024-10-20 kicad formating and others
    [APG_Sensor_Test_Board.kicad_sch, Baro.kicad_sch, Component_Selection.xlsx, Debug.kicad_sch, ESP32.kicad_sch, Flash.kicad_sch, High_G_Accel.kicad_sch, IMU.kicad_sch]
2024-10-22 added week dates and auto highlighting week
    [Gantt.xlsx]
2024-10-24 debug schematic done
    [Debug.kicad_sch, ESP32.kicad_sch]
2024-10-24 added flash schematic
    [Flash.kicad_sch]
2024-10-27 sensor schematics
    [Baro.kicad_sch, High_G_Accel.kicad_sch, IMU.kicad_sch]
2024-10-27 Cleaning up schematics
    [Baro.kicad_sch, Flash.kicad_sch, High_G_Accel.kicad_sch]
2024-10-29 10/29/24 work day
    [Gantt.xlsx]
2024-10-31 Gannon inspection decision to change IMU
    [APG_Sensor_Test_Board.kicad_sch, Debug.kicad_sch, ESP32.kicad_sch, Flash.kicad_sch, High_G_Accel.kicad_sch, IMU.kicad_sch, Power_and_USB.kicad_sch]
2024-11-01 Small schematic work
    [APG_Sensor_Test_Board.kicad_sch]
2024-11-03 Changed IMU and changed sensors to I2C
    [Baro.kicad_sch, High_G_Accel.kicad_sch, IMU.kicad_sch]
2024-11-03 changed IMU and switched sensors to I2C
2024-11-05 Main Schematic Complete
    [APG_Sensor_Test_Board.kicad_sch, Baro.kicad_sch, High_G_Accel.kicad_sch, IMU.kicad_sch, Power_and_USB.kicad_sch]
2024-11-05 Final proposal and Gantt
    [Gantt.xlsx]
2024-11-05 reaninotate and begin footprints
    [APG_Sensor_Test_Board.kicad_sch, Baro.kicad_sch, Debug.kicad_sch, ESP32.kicad_sch, Flash.kicad_sch, High_G_Accel.kicad_sch, IMU.kicad_sch, Power_and_USB.kicad_sch]
2024-11-07 completed footprint assignment
    [Debug.kicad_sch, IMU.kicad_sch, Power_and_USB.kicad_sch]
2024-11-07 JLC part numbers
    [Baro.kicad_sch, Debug.kicad_sch, Flash.kicad_sch, High_G_Accel.kicad_sch, Power_and_USB.kicad_sch]
2024-11-08 added test points
    [APG_Sensor_Test_Board.kicad_sch, Power_and_USB.kicad_sch]
2024-11-09 MOved IMU and HIGH G to SPI other misc changes
    [APG_Sensor_Test_Board.kicad_sch, Baro.kicad_sch, Debug.kicad_sch, ESP32.kicad_sch, Flash.kicad_sch, High_G_Accel.kicad_sch, IMU.kicad_sch, Power_and_USB.kicad_sch]
2024-11-10 Updated schematic a bit and added logo to pictures folder
2024-11-10 TVS protection began layout
    [APG_Sensor_Test_Board.kicad_pcb, Debug.kicad_sch, ESP32.kicad_sch, Power_and_USB.kicad_sch]
2024-11-11 Layout and routing
    [APG_Sensor_Test_Board.kicad_pcb, APG_Sensor_Test_Board.kicad_sch, Baro.kicad_sch, Debug.kicad_sch, ESP32.kicad_sch, Flash.kicad_sch, High_G_Accel.kicad_sch, IMU.kicad_sch]
2024-11-12 layout changes
    [APG_Sensor_Test_Board.kicad_pcb, APG_Sensor_Test_Board.kicad_sch, Power_and_USB.kicad_sch]
2024-11-12 Worked on final presentation
    [Gantt.xlsx]
2024-11-12 new tvs diode debug changes
    [APG_Sensor_Test_Board.kicad_pcb, Debug.kicad_sch, Power_and_USB.kicad_sch]
2024-11-12 Edit PCB and Update component values
    [APG_Sensor_Test_Board.kicad_pcb, APG_Sensor_Test_Board.kicad_sch, Baro.kicad_sch, Debug.kicad_sch, ESP32.kicad_sch, IMU.kicad_sch]
2024-11-14 APG Sensor Board V1.1 Production
    [APG_Sensor_Test_Board-B_Cu.gbl, APG_Sensor_Test_Board-B_Mask.gbs, APG_Sensor_Test_Board-B_Paste.gbp, APG_Sensor_Test_Board-B_Silkscreen.gbo, APG_Sensor_Test_Board-Edge_Cuts.gm1, APG_Sensor_Test_Board-F_Cu.gtl, APG_Sensor_Test_Board-F_Mask.gts, APG_Sensor_Test_Board-F_Paste.gtp]
2024-11-24 worked on presentation and verification plan
    [APG_SrDesCombinedSheet.xlsx, APG_SrDesCombinedSheet1.xlsx]
2024-11-30 updated MCU,PCB design, and budget slides
2024-12-01 Presentation work
    [Gantt.xlsx]
2024-12-05 Added inventory excel cause why not
    [Inventory of Parts.xlsx]
2024-12-05 Forgot stuff
    [Inventory of Parts.xlsx]
2024-12-12 final report schematic section
